PoleG97/mixed_signal_course/doc/front.png

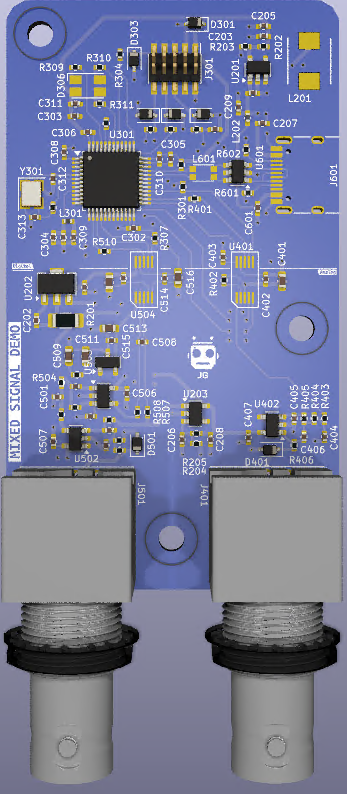
doc/front.png
