PoleG97/mixed_signal_course/outputs/blender_render/untitled.png

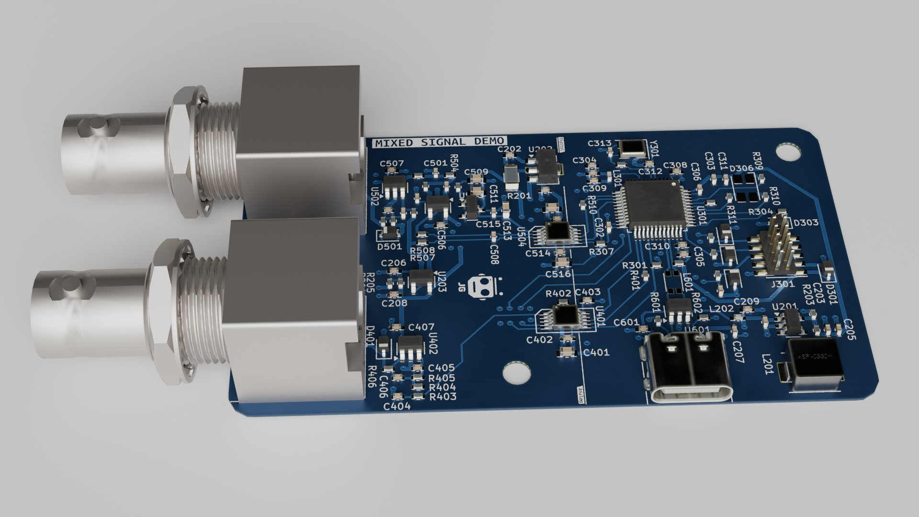
outputs/blender_render/untitled.png
