PoleG97/mixed_signal_course/doc/back.png

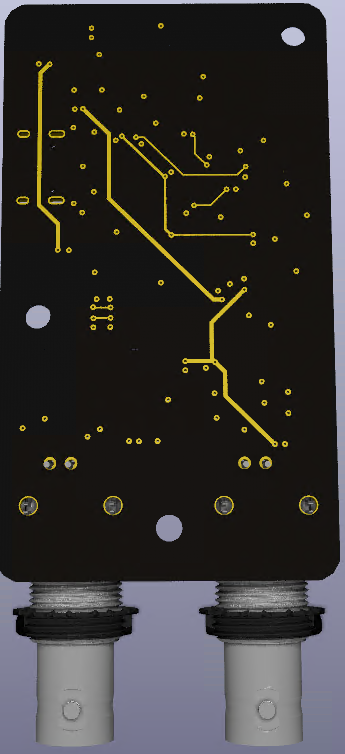
doc/back.png
