PoleG97/mixed_signal_course/outputs/mixed_signal.pdf

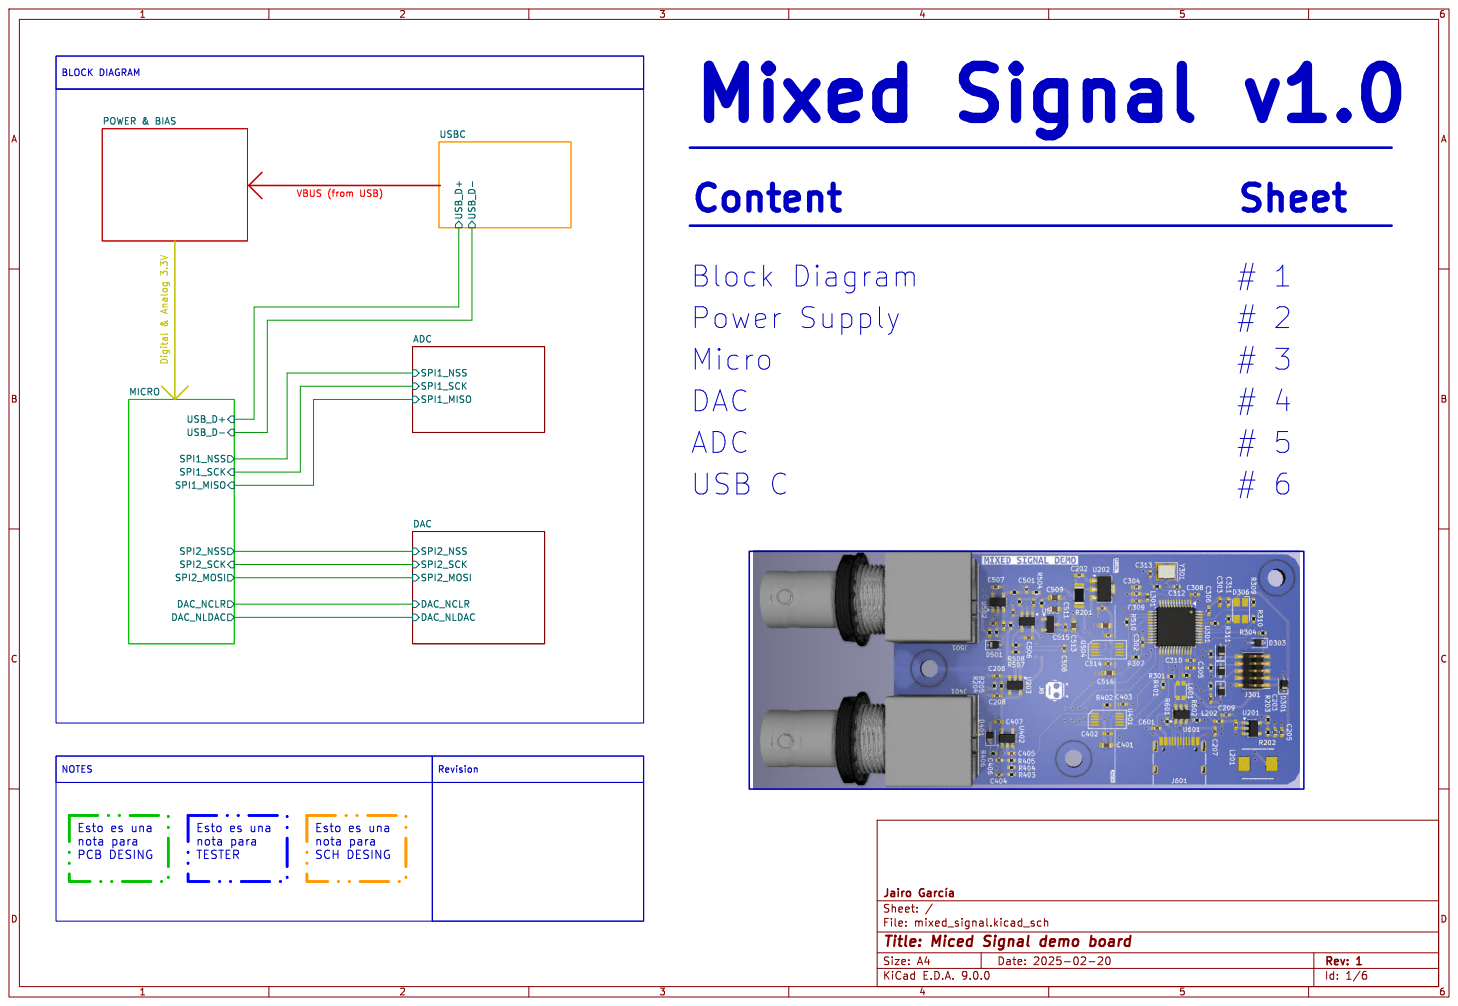
[picture p4: page 1]

Id: 1/6 Title: Miced Signal demo board

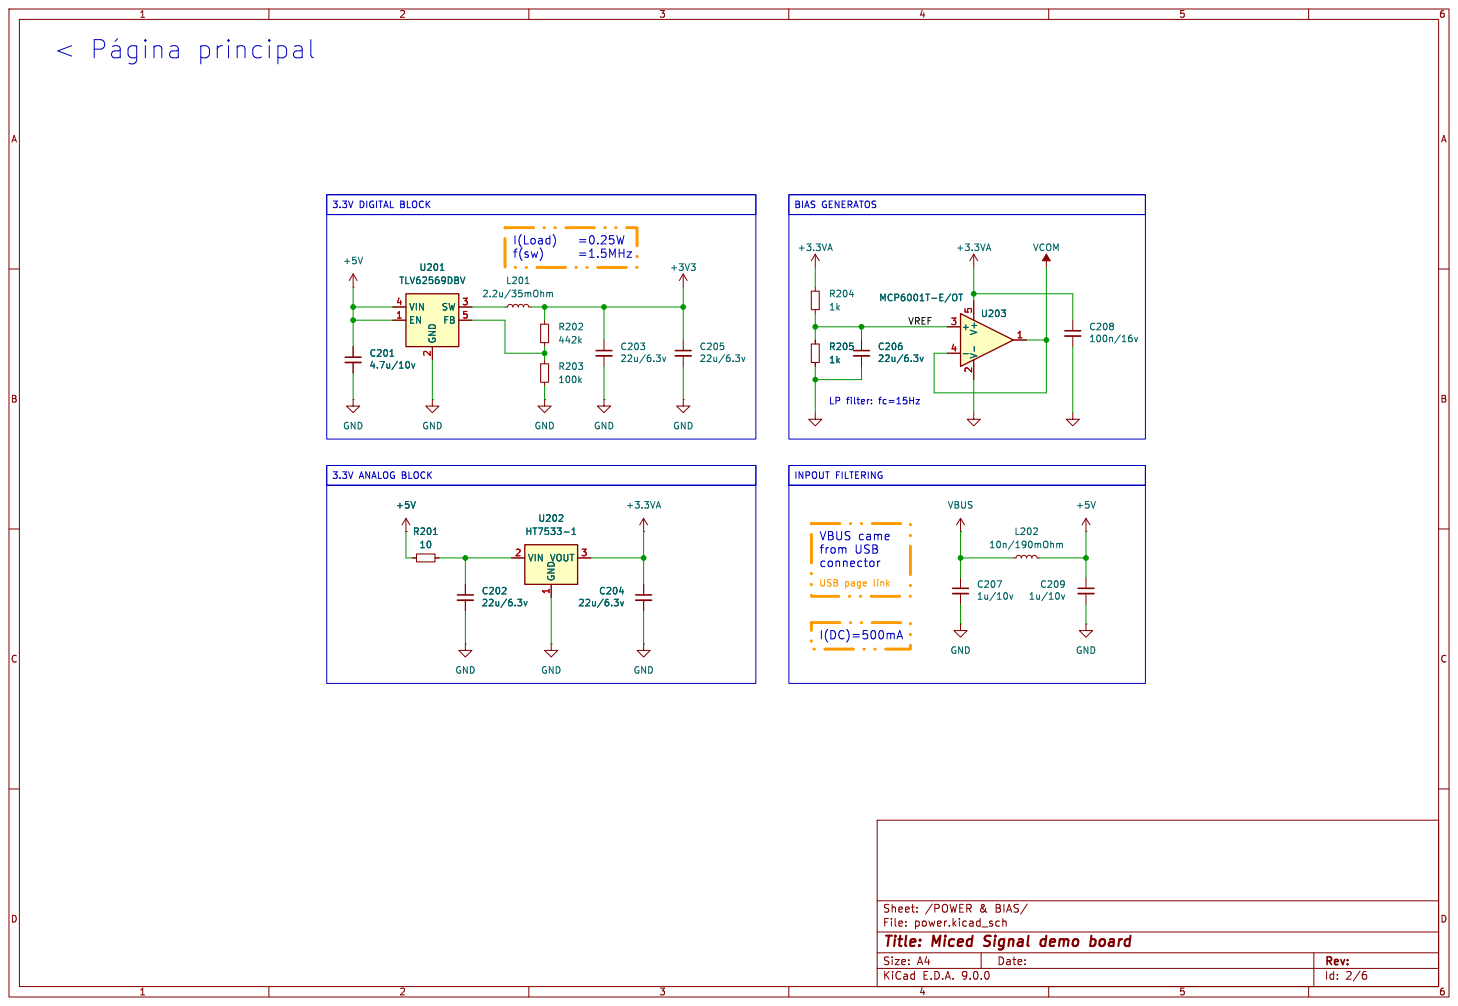
[picture p5: page 2]

Id: 2/6 Title: Miced Signal demo board

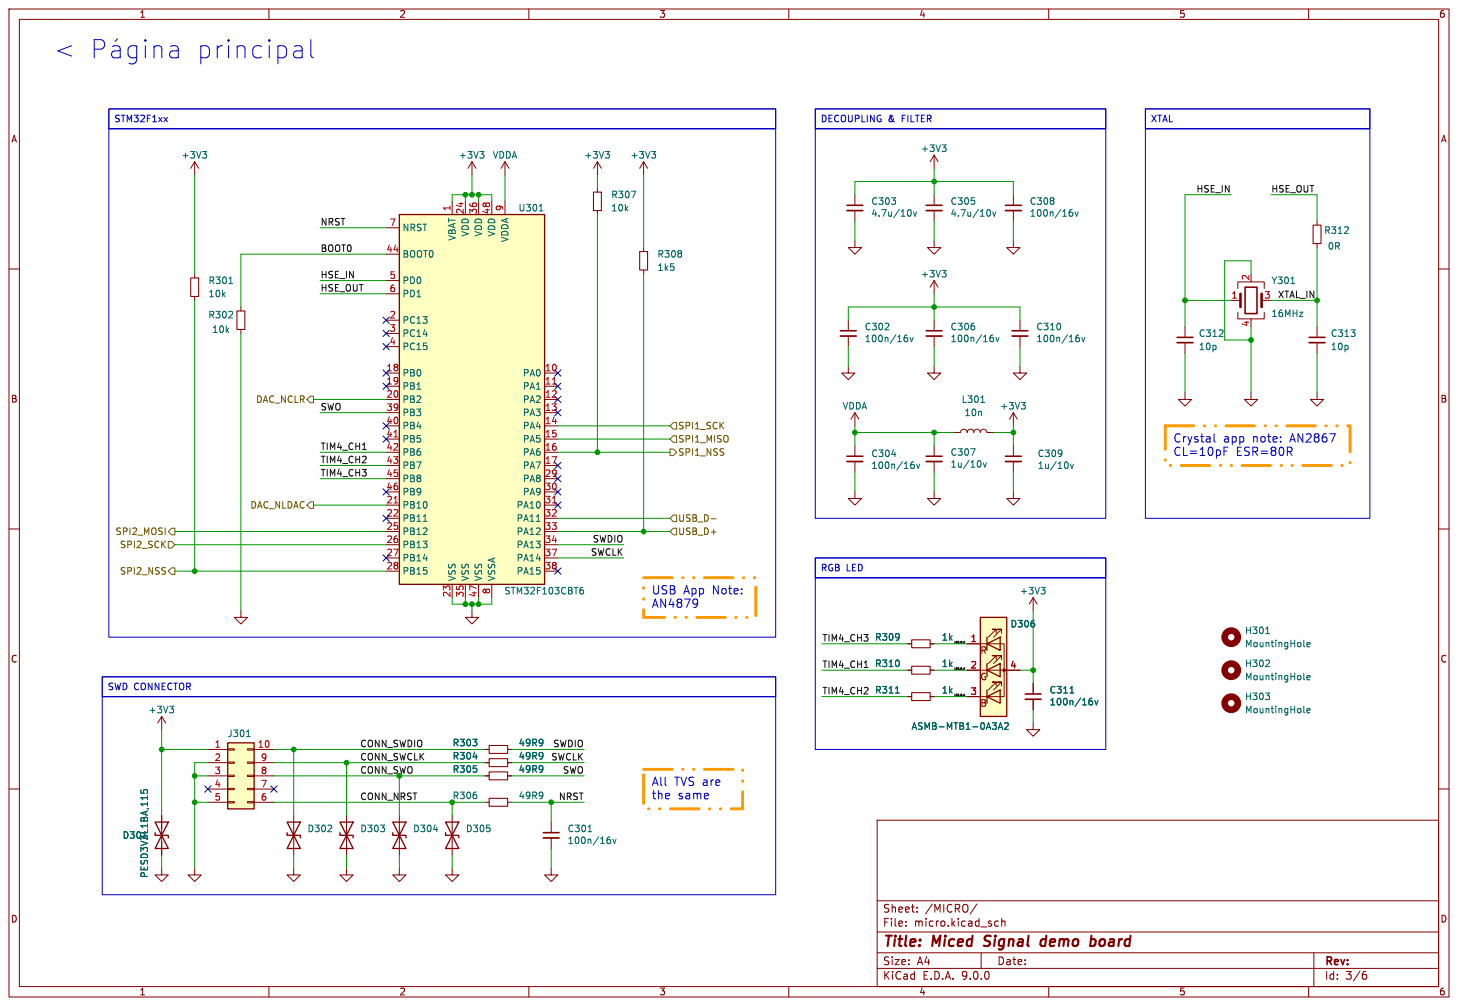
[picture p6: page 3]

1 VSS 23 VDD 24 VSS 35 VDD 36 VSS 47 VDD 48 VSSA

Id: 3/6 Title: Miced Signal demo board

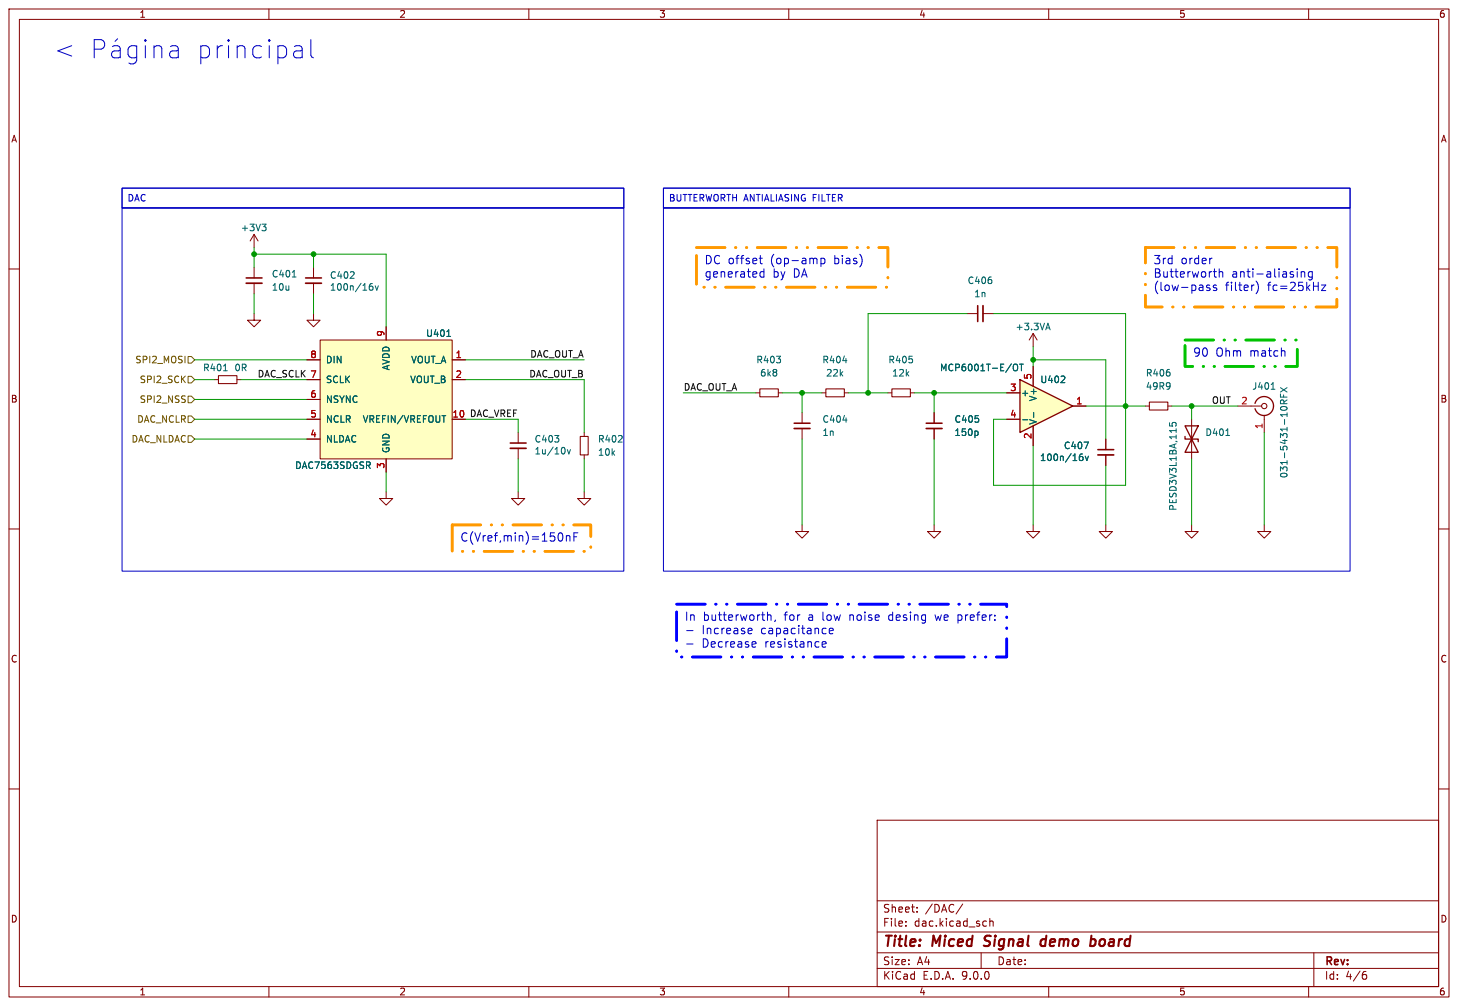
[picture p7: page 4]

3 DIN 8 SCLK 7 NSYNC 6 NCLR 5 NLDAC 4 U401 DAC7563SDGSR

3 DIN 8 SCLK 7 NSYNC 6 NCLR 5 NLDAC 4 C407

File: dac.kicad_sch Sheet: /DAC/
Id: 4/6 Title: Miced Signal demo board

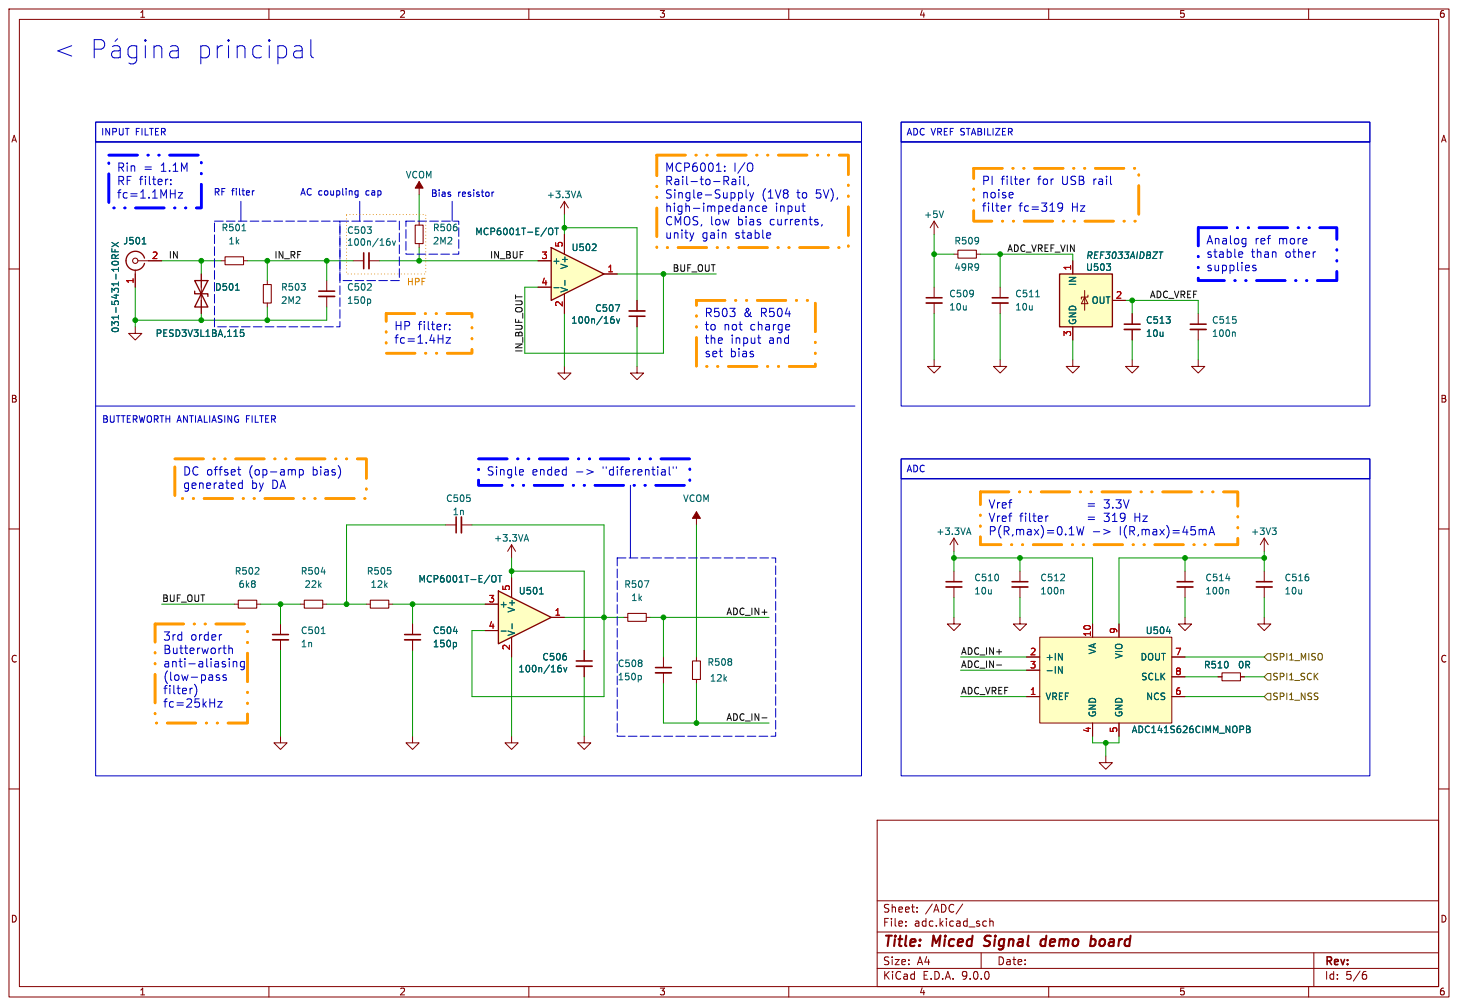
[picture p8: page 5]

MCP6001: I/O
Rail-to-Rail,
CMOS, low bias currents,
unity gain stable

PI filter for USB rail
noise

Id: 5/6 Title: Miced Signal demo board

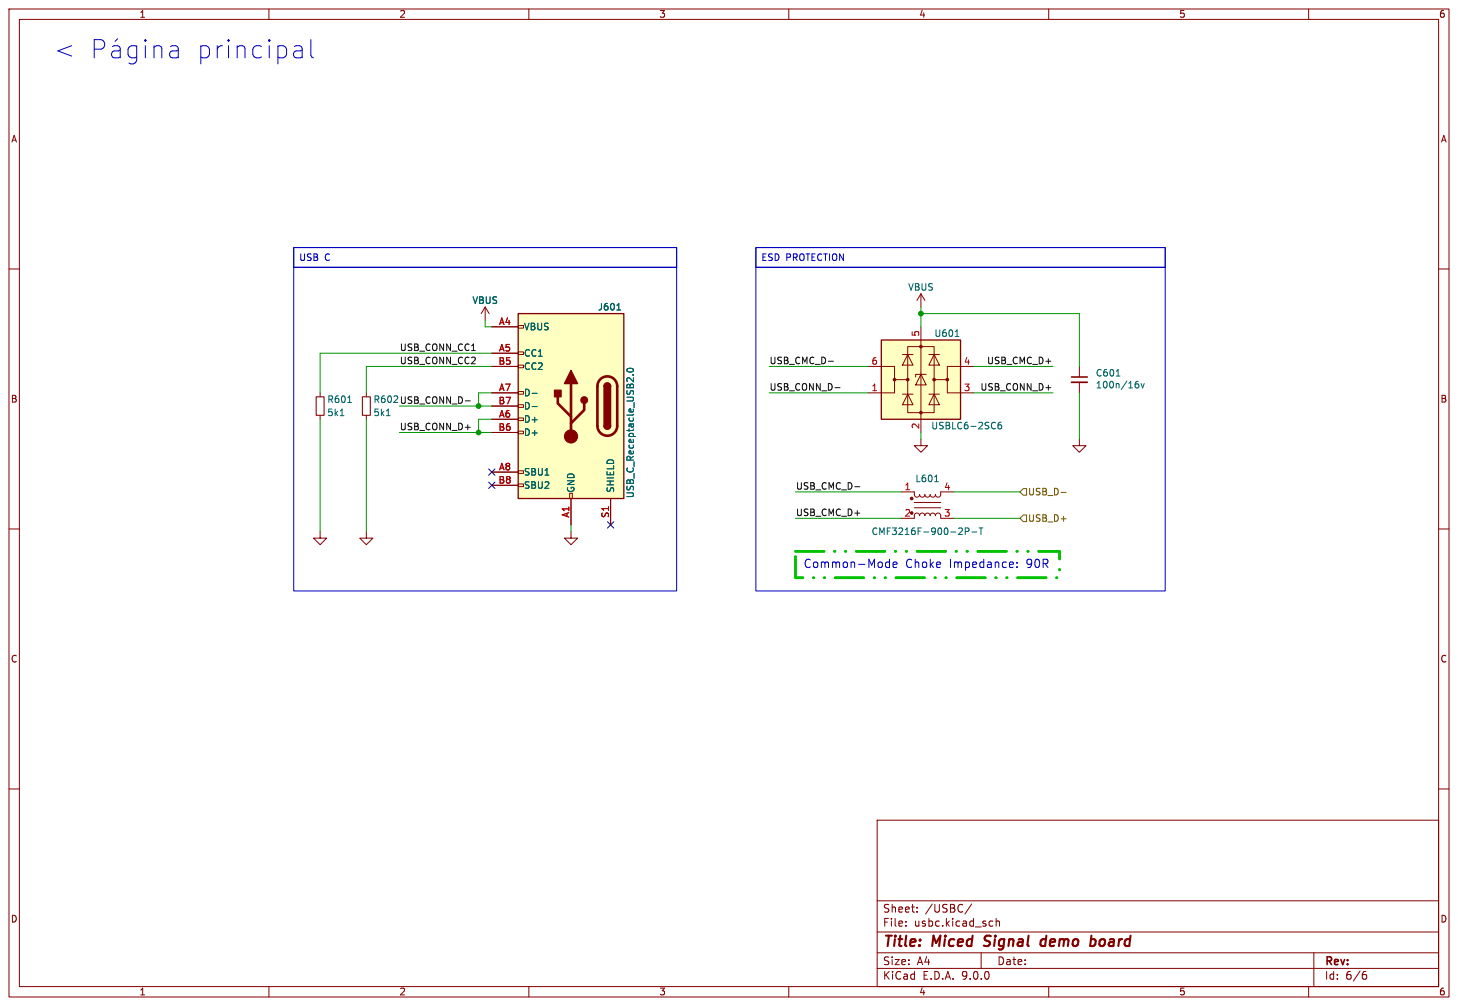
[picture p9: page 6]

File: usbc.kicad_sch Sheet: /USBC/
Id: 6/6 Title: Miced Signal demo board
