PoleG97/mixed_signal_course/outputs/file_outputs/SCH.pdf

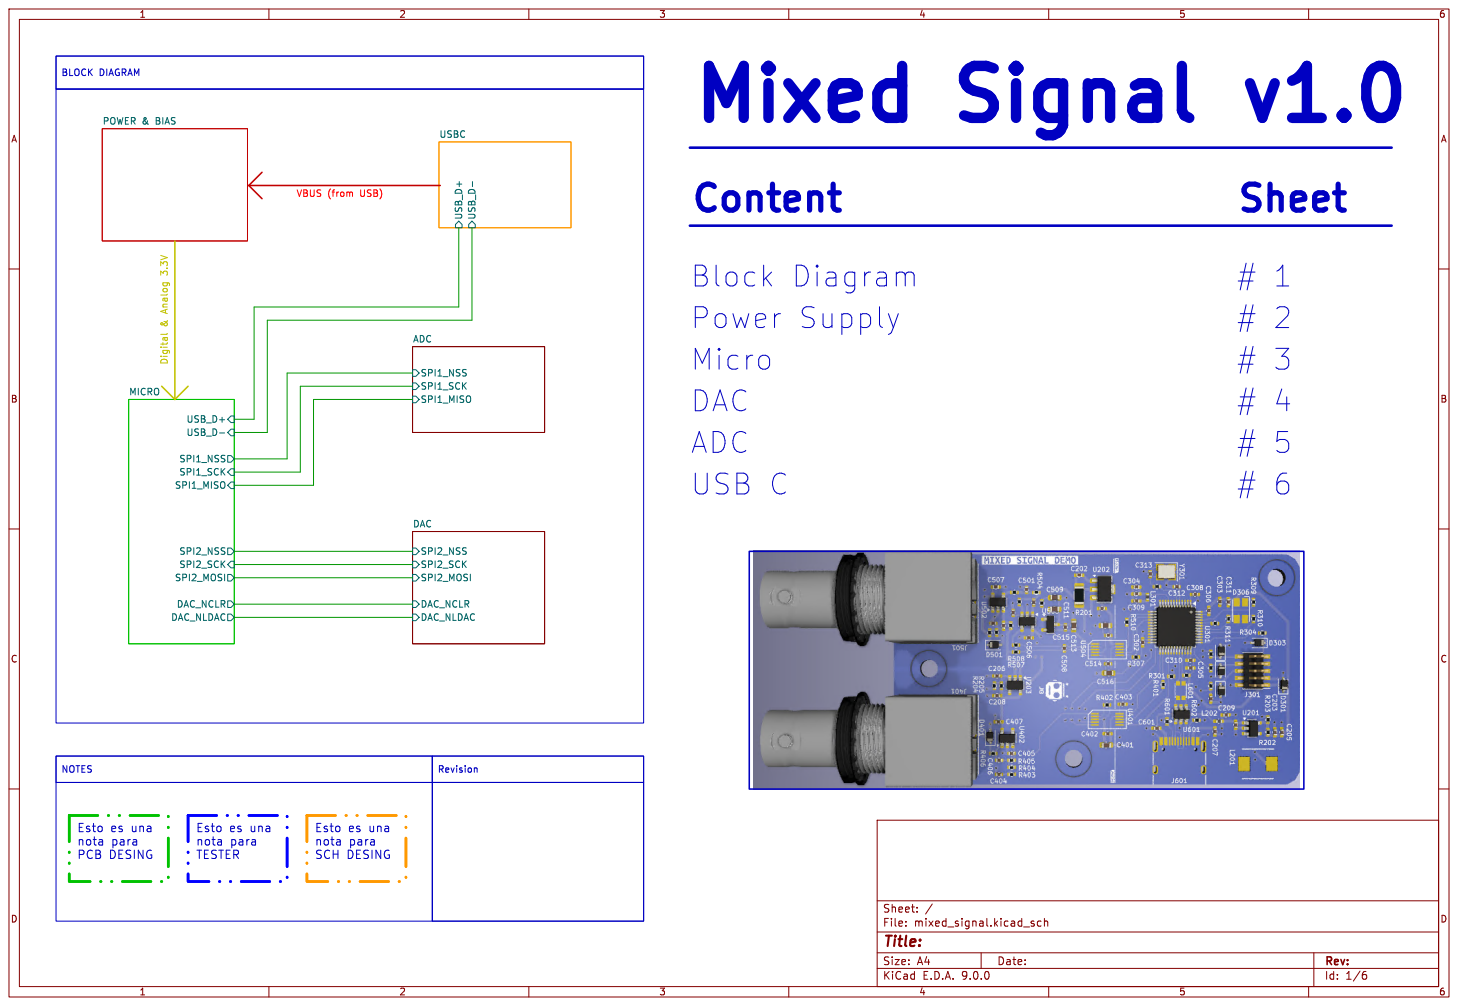
[picture p10: page 1]

BLOCK DIAGRAM Esto es una

Id: 1/6 Title: File: mixed_signal.kicad_sch Sheet: / DAC_NCLR
DAC_NLDAC

NOTES Esto es una

Revision

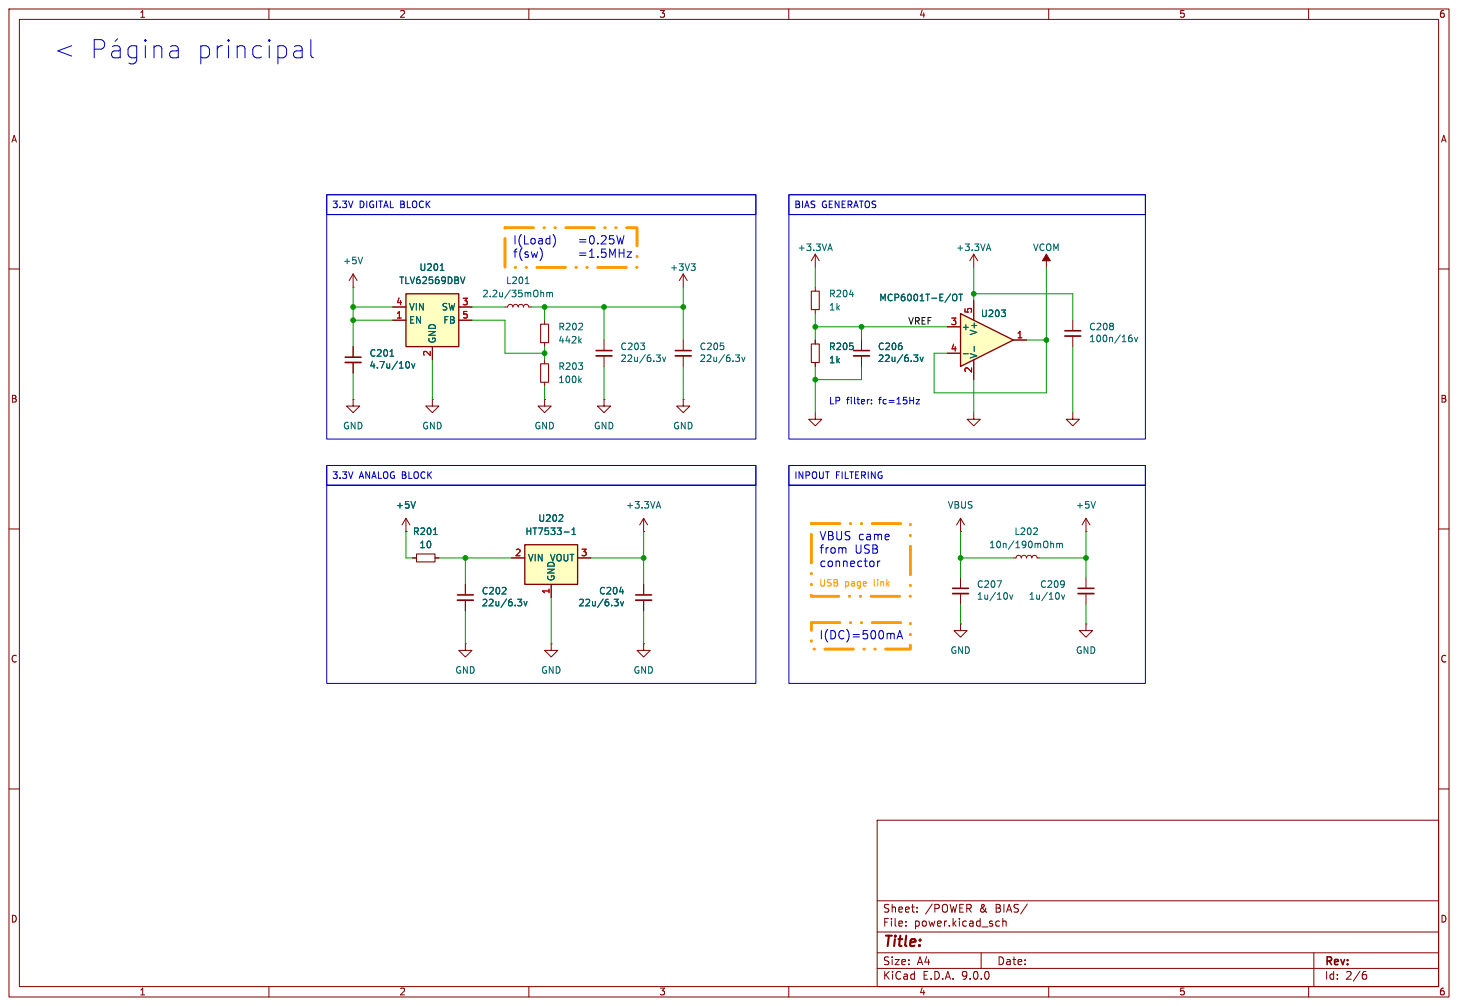
[picture p11: page 2]

INPOUT FILTERING < þÿPágina principal

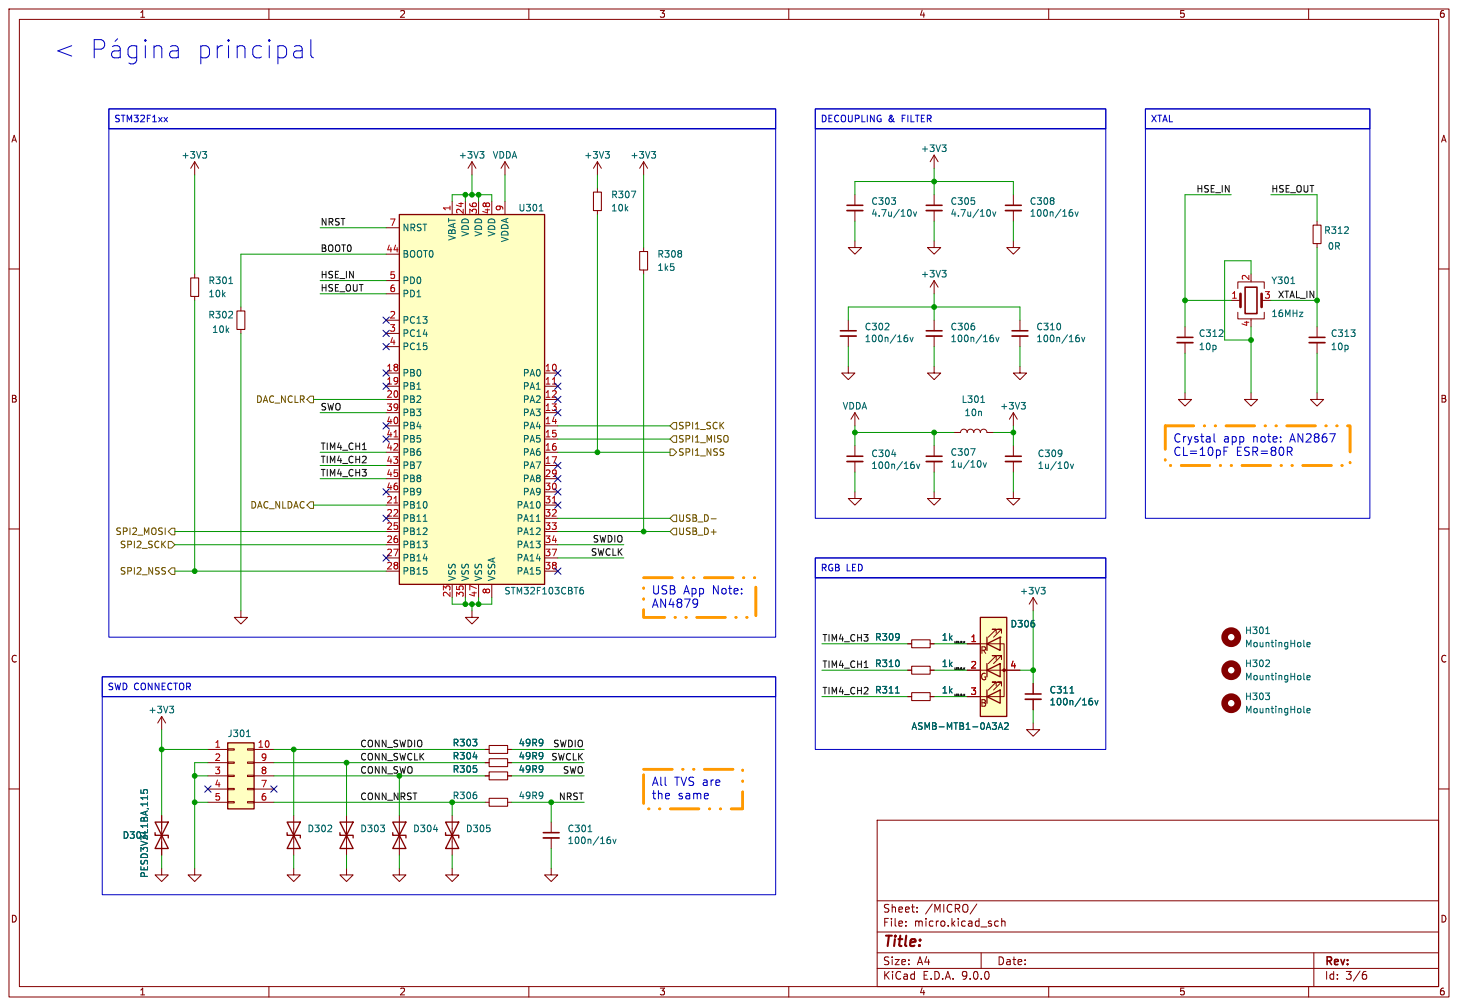
[picture p12: page 3]

1 VSS 23 VDD 24 VSS 35 VDD 36 VSS 47 VDD 48 VSSA

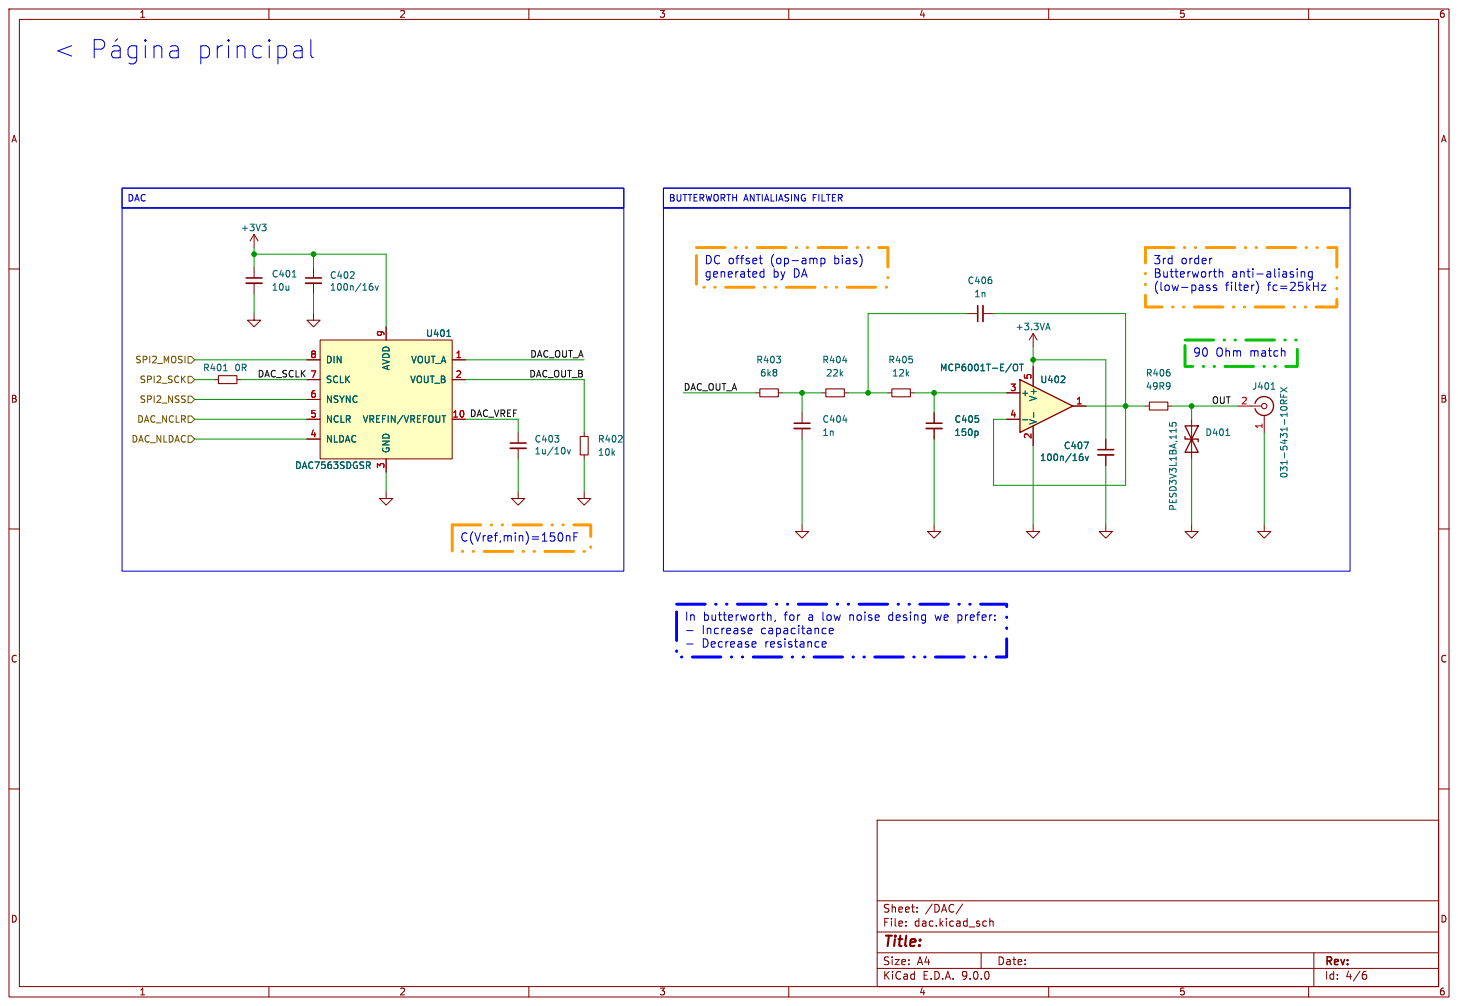
[picture p13: page 4]

3 DIN 8 SCLK 7 NSYNC 6 NCLR 5 NLDAC 4 U401 DAC7563SDGSR

3 DIN 8 SCLK 7 NSYNC 6 NCLR 5 NLDAC 4 C407

Id: 4/6 Title: File: dac.kicad_sch Sheet: /DAC/

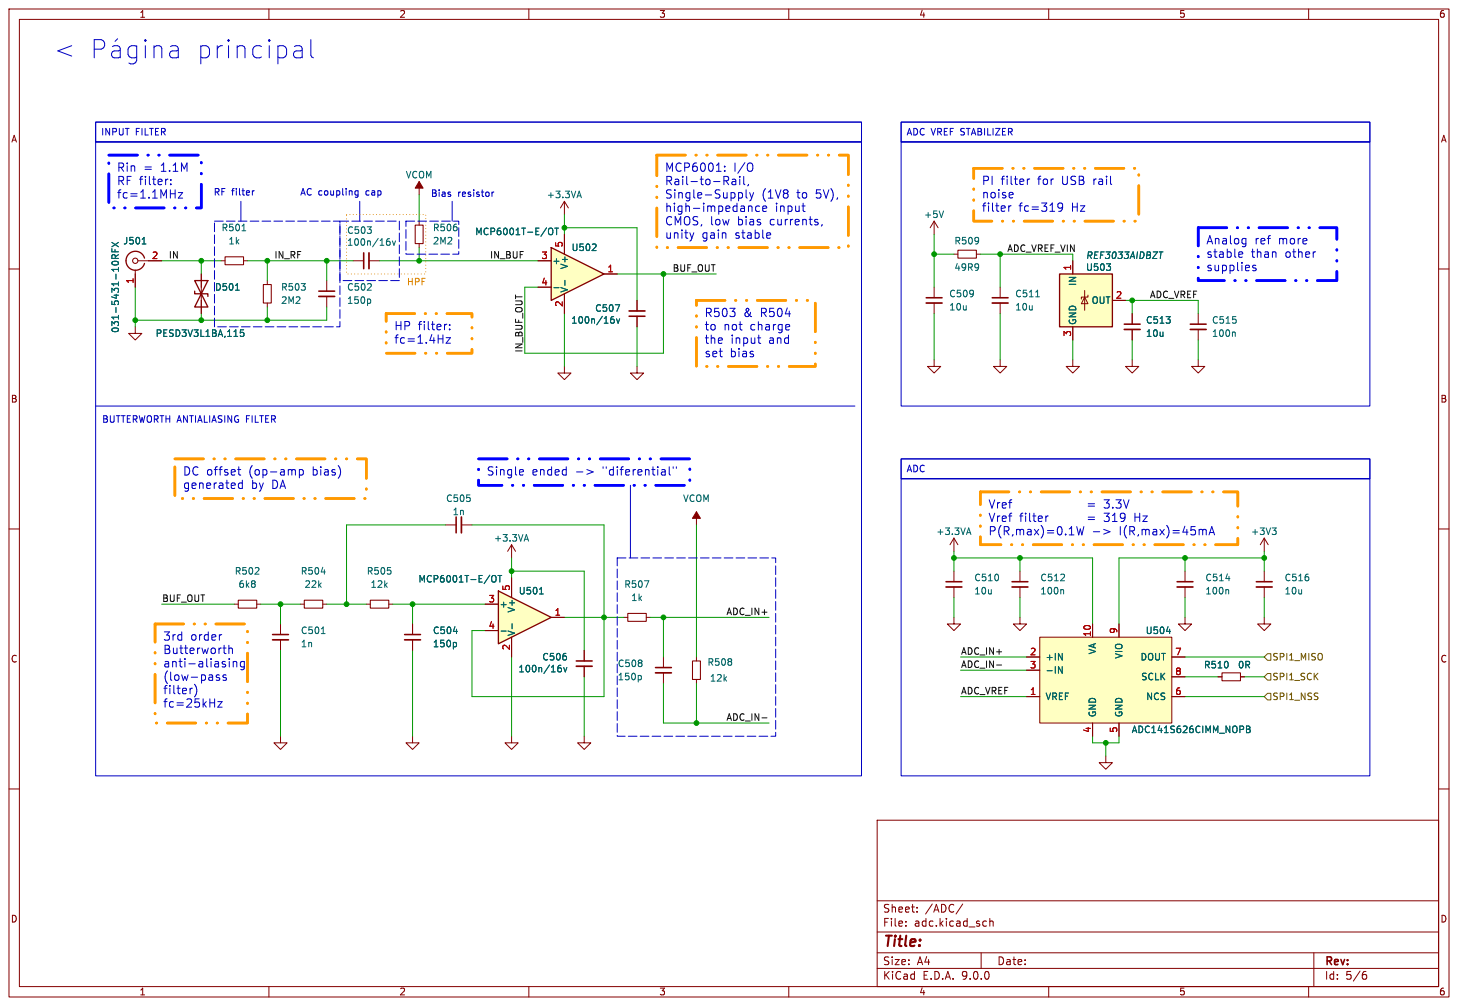
[picture p14: page 5]

MCP6001: I/O
Rail-to-Rail,
CMOS, low bias currents,
unity gain stable

Id: 5/6 Title: File: adc.kicad_sch Sheet: /ADC/

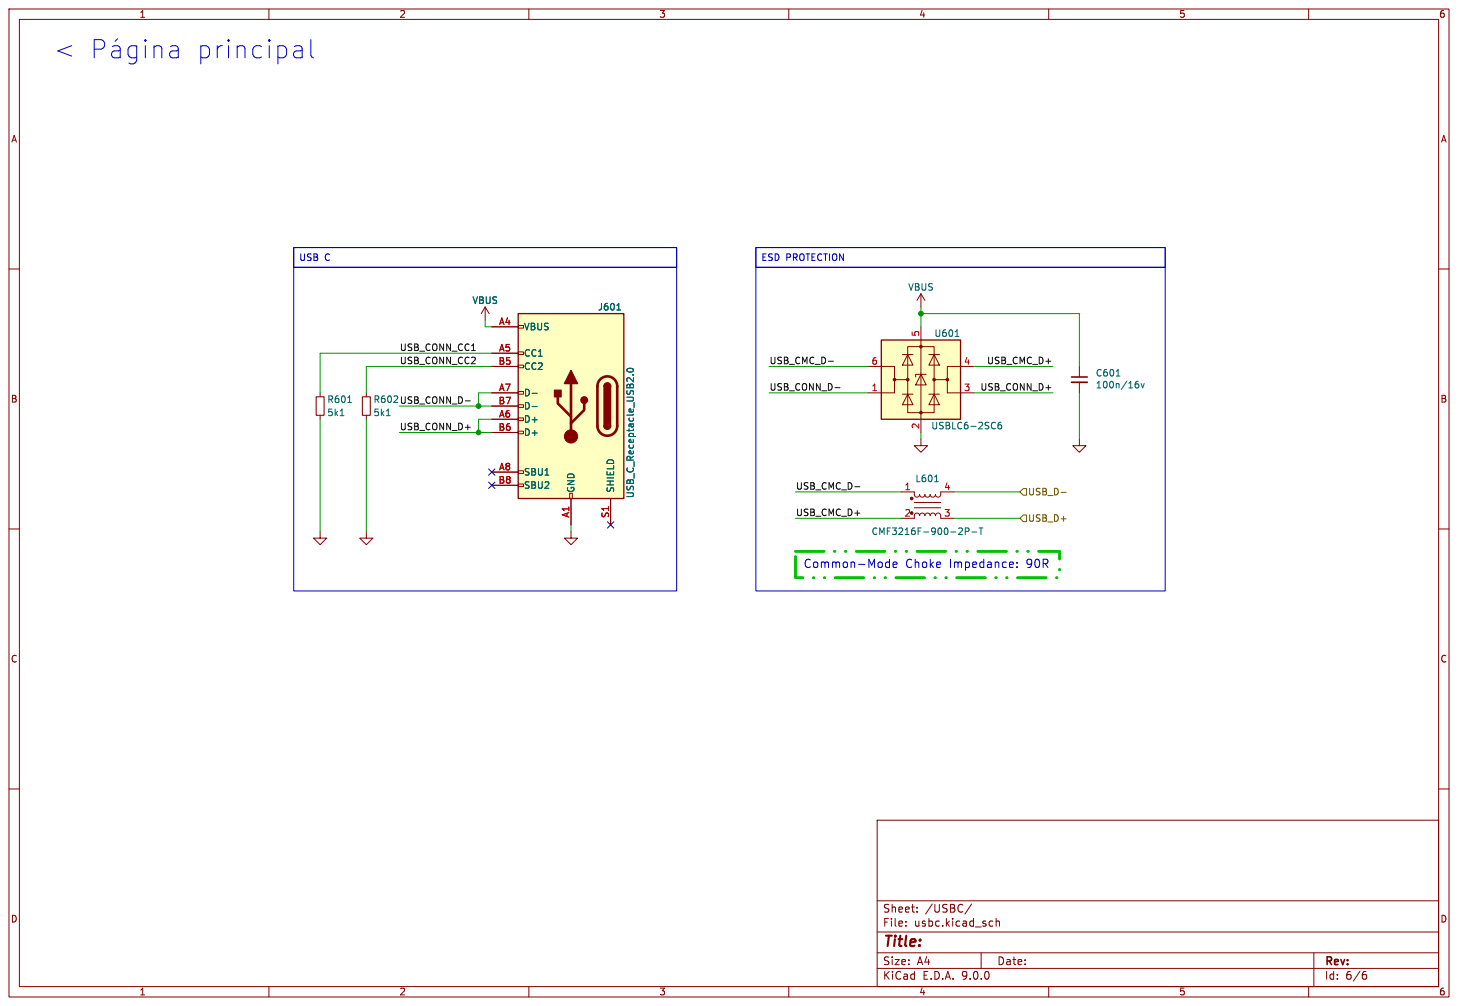
[picture p15: page 6]

Id: 6/6 Title: File: usbc.kicad_sch Sheet: /USBC/
