PoleG97/mixed_signal_course/mixed_signal.kicad_pcb

## KiCad design mixed_signal.kicad_pcb (2025-03-20)

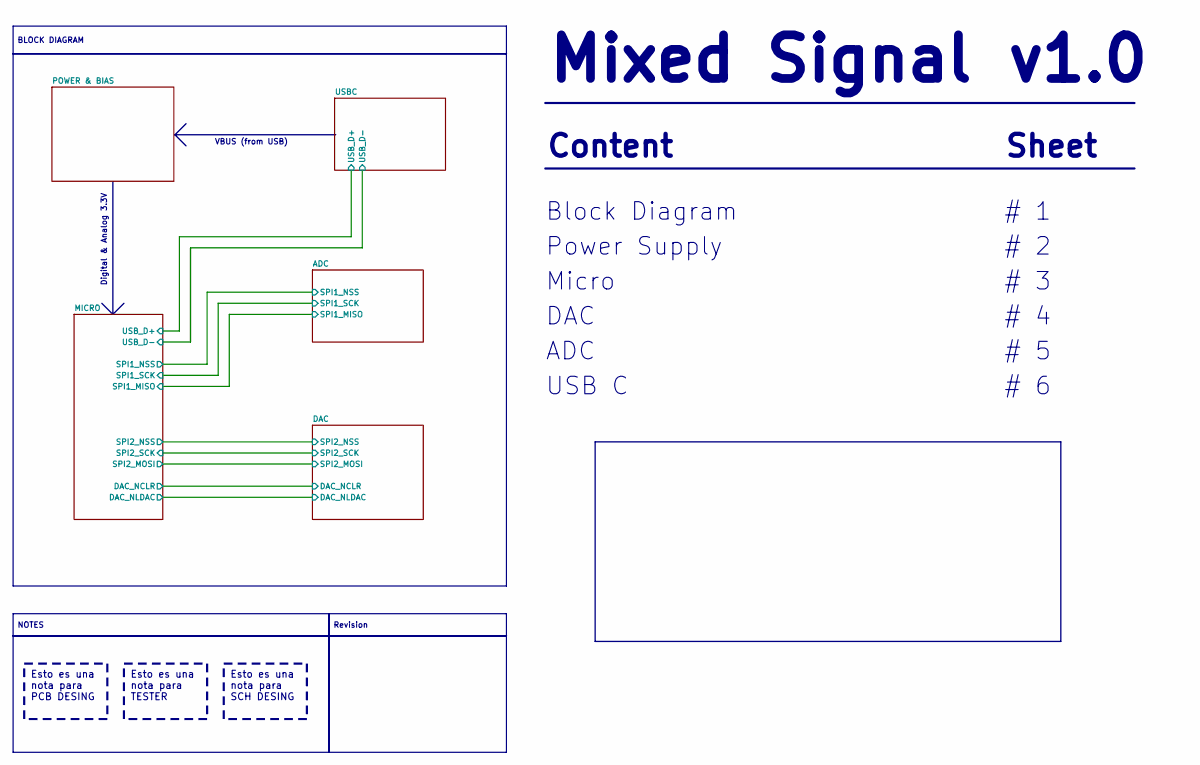
[picture p16: schematic mixed_signal.kicad_sch, Miced Signal demo board]

Notes on the sheet:
Micro
# 2
ADC
# 4
Power Supply
# 3
# 1
Content
USB C
v1.0
# 5
VBUS (from USB)
Block Diagram
Mixed Signal
DAC
Digital & Analog 3.3V
# 6
Sheet
Esto es una nota para TESTER
NOTES
Esto es una nota para SCH DESING
BLOCK DIAGRAM
Esto es una nota para PCB DESING
Revision

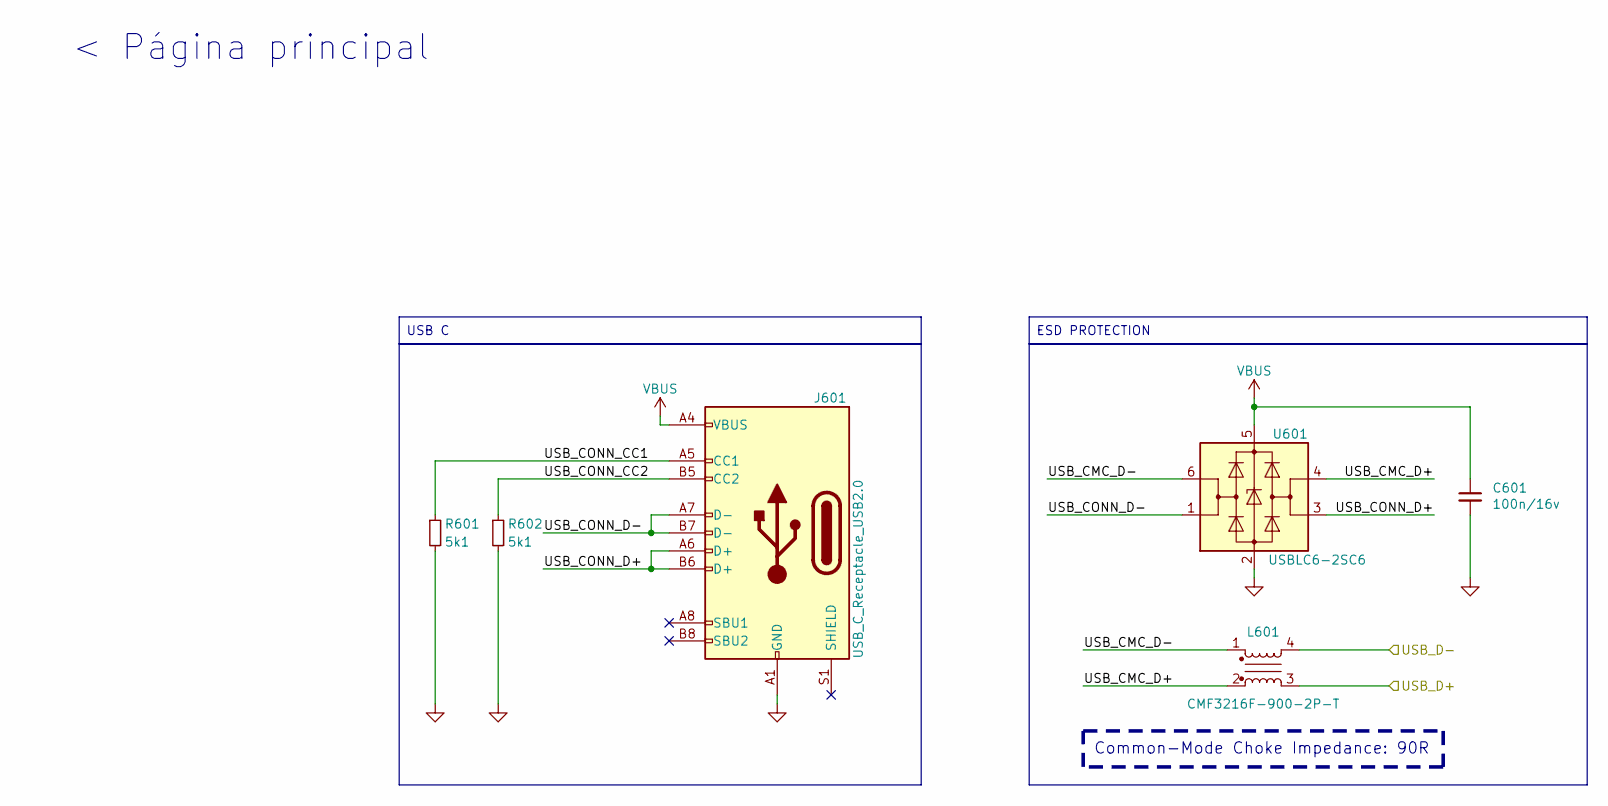
[picture p17: schematic usbc.kicad_sch, Miced Signal demo board]

Parts:
C601: 100n/16v; C_0402_1005Metric_Pad0.74x0.62mm_HandSolder; PART_NUMBER GRM155R71C104KA88J
J601: USB_C_Receptacle_USB2.0; USB_C_Receptacle_HRO_TYPE-C-31-M-12
L601: CMF3216F-900-2P-T; CMF3216F
R601, R602: 5k1; R_0402_1005Metric
U601: USBLC6-2SC6; SOT-23-6

Connections:
/MICRO/USB_D+: L601.3; also elsewhere on the board
/MICRO/USB_D-: L601.4; also elsewhere on the board
/USBC/USB_CMC_D+: L601.2, U601.4 (I/O2)
/USBC/USB_CMC_D-: L601.1, U601.6 (I/O1)
/USBC/USB_CONN_CC1: J601.A5 (CC1), R601.1
/USBC/USB_CONN_CC2: J601.B5 (CC2), R602.1
/USBC/USB_CONN_D+: J601.A6 (D+), J601.B6 (D+), U601.3 (I/O2)
/USBC/USB_CONN_D-: J601.A7 (D-), J601.B7 (D-), U601.1 (I/O1)
GND: C601.2, J601.A1 (GND), J601.A12 (GND), J601.B1 (GND), J601.B12 (GND), R601.2, R602.2, U601.2 (GND); also elsewhere on the board
VBUS: C601.1, J601.A4 (VBUS), J601.A9 (VBUS), J601.B4 (VBUS), J601.B9 (VBUS), U601.5 (VBUS); also elsewhere on the board

Notes on the sheet:
Common-Mode Choke Impedance: 90R
< Página principal
ESD PROTECTION
USB C

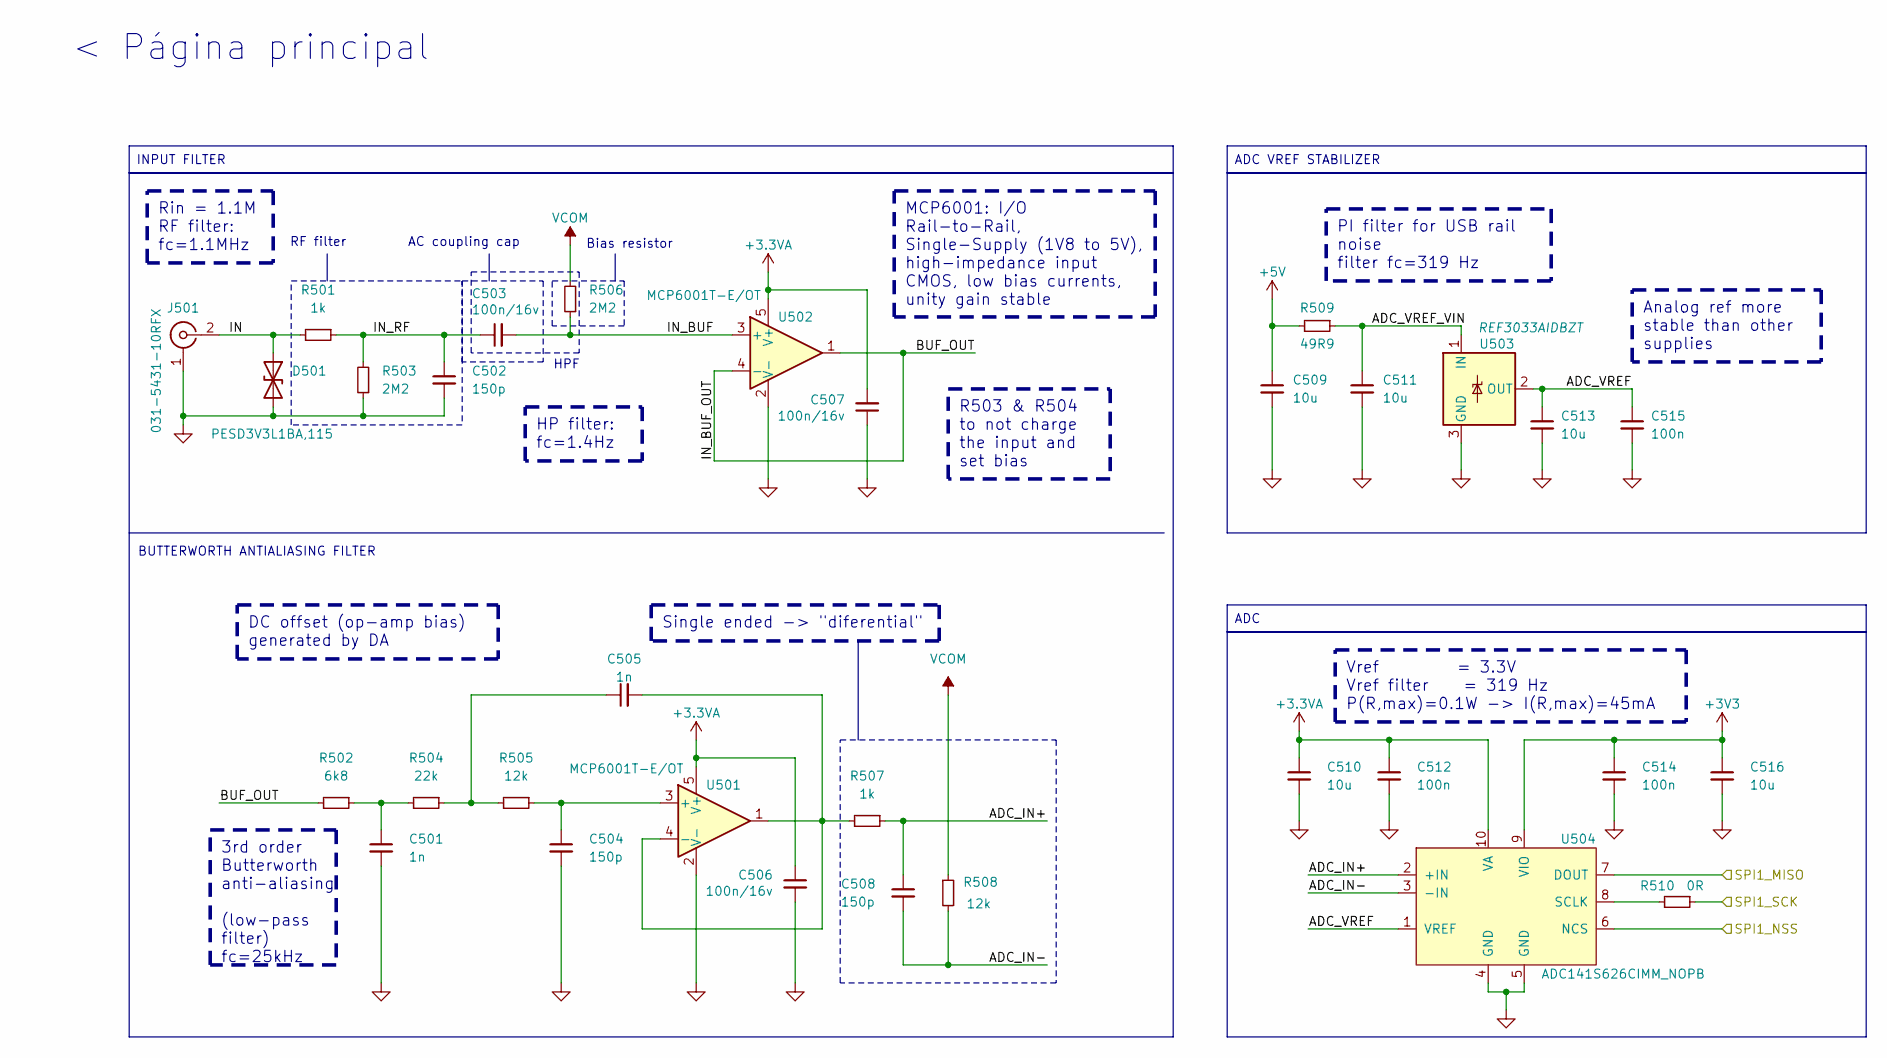
[picture p18: schematic adc.kicad_sch, Miced Signal demo board]

Parts:
C501, C505: 1n; C_0402_1005Metric
C502, C504, C508: 150p; C_0402_1005Metric
C503, C506, C507: 100n/16v; C_0402_1005Metric_Pad0.74x0.62mm_HandSolder; PART_NUMBER GRM155R71C104KA88J
C509, C510, C511, C513, C516: 10u; C_0603_1608Metric
C512, C514, C515: 100n; C_0402_1005Metric
D501: PESD3V3L1BA,115; D_SOD-323
J501: 031-5431-10RFX
R501, R507: 1k; R_0402_1005Metric
R502: 6k8; R_0402_1005Metric
R503, R506: 2M2; R_0402_1005Metric
R504: 22k; R_0402_1005Metric
R505, R508: 12k; R_0402_1005Metric
R509: 49R9; R_0402_1005Metric
R510: 0R; R_0402_1005Metric
U501, U502: MCP6001T-E/OT; SOT-23-5
U503: REF3033AIDBZT; SOT-23
U504: ADC141S626CIMM_NOPB; VSSOP-10

Connections:
+3.3VA: C506.1, C507.2, C510.1, C512.1, U501.5 (V+), U502.5 (V+), U504.10 (VA); also elsewhere on the board
+3V3: C514.1, C516.1, U504.9 (VIO); also elsewhere on the board
+5V: C509.1, R509.2; also elsewhere on the board
/ADC/ADC_IN+: C508.1, R507.1, U504.2 (+IN)
/ADC/ADC_IN-: C508.2, R508.2, U504.3 (-IN)
/ADC/ADC_VREF: C513.1, C515.1, U503.2 (OUT), U504.1 (VREF)
/ADC/ADC_VREF_VIN: C511.1, R509.1, U503.1 (IN)
/ADC/BUF_OUT: R502.2, U502.1, U502.4 (-)
/ADC/IN: D501.1 (A1), J501.2 (Ext), R501.2
/ADC/IN_BUF: C503.2, R506.1, U502.3 (+)
/ADC/IN_RF: C502.1, C503.1, R501.1, R503.2
/ADC/SPI1_MISO: U504.7 (DOUT); also elsewhere on the board
/ADC/SPI1_NSS: U504.6 (NCS); also elsewhere on the board
/ADC/SPI1_SCK: R510.1; also elsewhere on the board
GND: C501.2, C502.2, C504.2, C506.2, C507.1, C509.2, C510.2, C511.2, C512.2, C513.2, C514.2, C515.2, C516.2, D501.2 (A2), J501.1 (In), R503.1, U501.2 (V-), U502.2 (V-), U503.3 (GND), U504.4 (GND), U504.5 (GND); also elsewhere on the board
unnamed: C501.1, R502.1, R504.2
unnamed: C505.1, R504.1, R505.2
unnamed: C504.1, R505.1, U501.3 (+)
unnamed: C505.2, R507.2, U501.1, U501.4 (-)
unnamed: R510.2, U504.8 (SCLK)
VCOM: R506.2, R508.1; also elsewhere on the board

Notes on the sheet:
RF filter
AC coupling cap
HPF
BUTTERWORTH ANTIALIASING FILTER
Bias resistor
ADC
Vref = 3.3V Vref filter = 319 Hz P(R,max)=0.1W -> I(R,max)=45mA
HP filter: fc=1.4Hz
INPUT FILTER
ADC VREF STABILIZER
Single ended -> "diferential"
MCP6001: I/O Rail-to-Rail, Single-Supply (1V8 to 5V), high-impedance input CMOS, low bias currents, unity gain stable
PI filter for USB rail noise filter fc=319 Hz
Rin = 1.1M RF filter: fc=1.1MHz
DC offset (op-amp bias) generated by DA
3rd order Butterworth anti-aliasing (low-pass filter) fc=25kHz
Analog ref more stable than other supplies
R503 & R504 to not charge the input and set bias
< Página principal

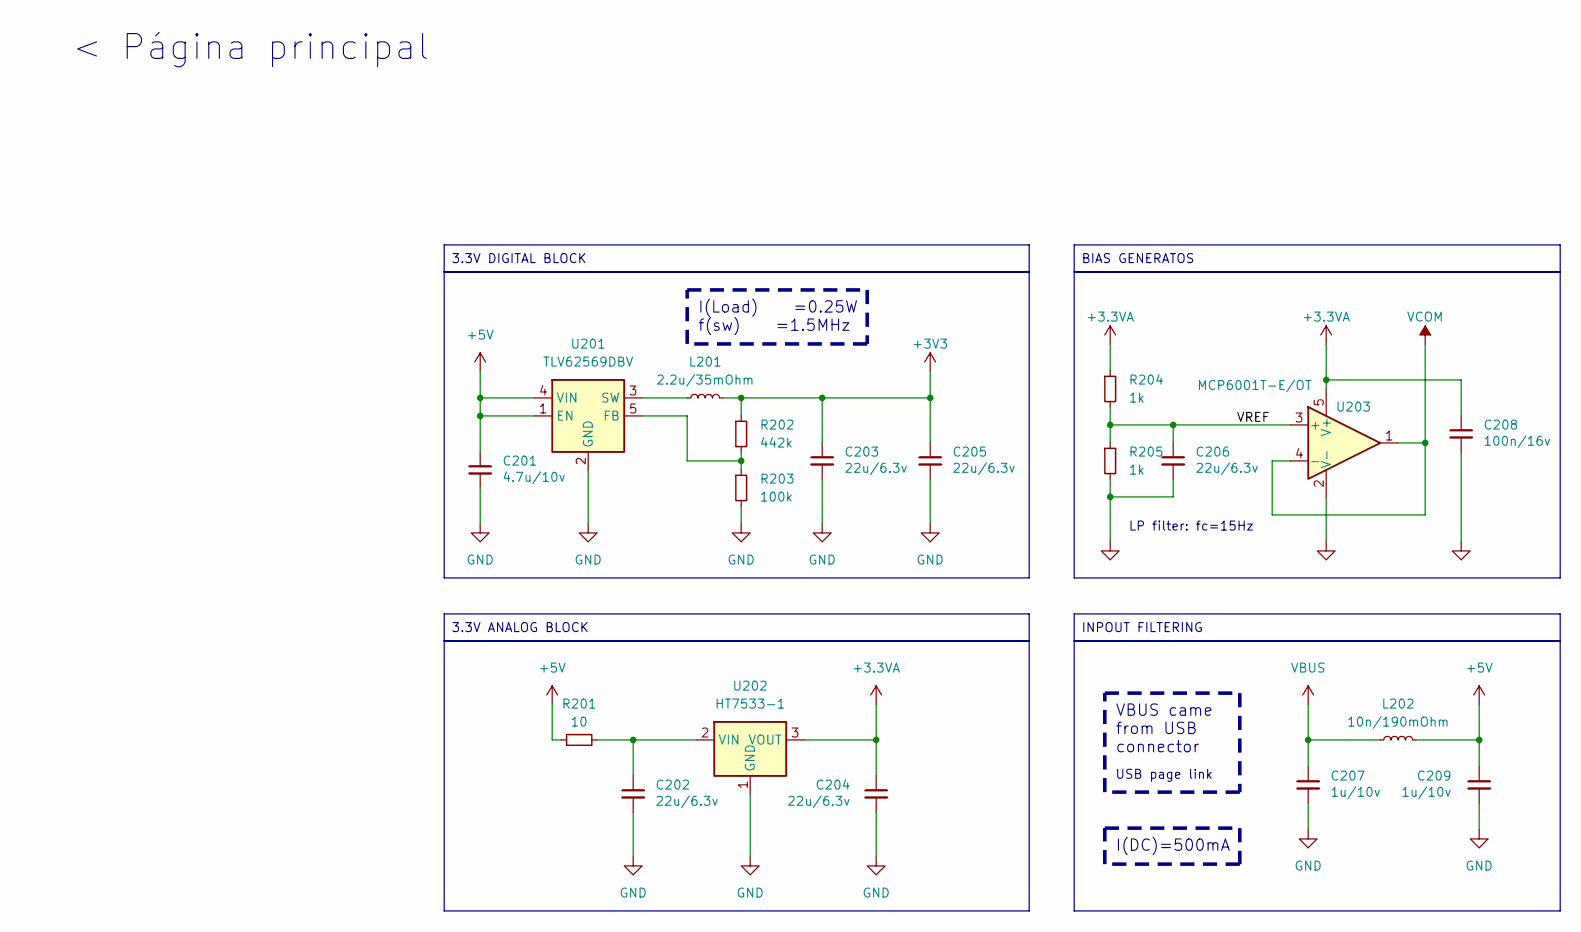
[picture p19: schematic power.kicad_sch, Miced Signal demo board]

Parts:
C201: 4.7u/10v; C_0402_1005Metric_Pad0.74x0.62mm_HandSolder; PART_NUMBER C1005X5R1A475K050BC
C202, C203, C204, C205, C206: 22u/6.3v; C_0402_1005Metric_Pad0.74x0.62mm_HandSolder; PART_NUMBER GRJ155R60J106ME11D
C207, C209: 1u/10v; C_0402_1005Metric_Pad0.74x0.62mm_HandSolder; PART_NUMBER CL05B104KP5NNNC
C208: 100n/16v; C_0402_1005Metric_Pad0.74x0.62mm_HandSolder; PART_NUMBER GRM155R71C104KA88J
L201: 2.2u/35mOhm; IND_ASPI-0530HI-2R2M-T2; PART_NUMBER ASPI-0530HI-2R2M-T2
L202: 10n/190mOhm; L_0402_1005Metric_Pad0.77x0.64mm_HandSolder; PART_NUMBER LQG15WZ10NH02D
R201: 10; R_1206_3216Metric_Pad1.30x1.75mm_HandSolder; PART_NUMBER Susumu
R202: 442k; R_0402_1005Metric
R203: 100k; R_0402_1005Metric
R204, R205: 1k; R_0402_1005Metric; PART_NUMBER ERJ-2RKF1001X
U201: TLV62569DBV; SOT-23-5
U202: HT7533-1; SOT-89-3
U203: MCP6001T-E/OT; SOT-23-5; PART_NUMBER MCP6001T-E/OT

Connections:
+3.3VA: C204.1, C208.1, R204.1, U202.3 (VOUT), U203.5 (V+); also elsewhere on the board
+3V3: C203.1, C205.1, L201.2, R202.1; also elsewhere on the board
+5V: C201.1, C209.1, L202.2, R201.1, U201.1 (EN), U201.4 (VIN); also elsewhere on the board
/POWER & BIAS/VREF: C206.1, R204.2, R205.1, U203.3 (+)
GND: C201.2, C202.2, C203.2, C204.2, C205.2, C206.2, C207.2, C208.2, C209.2, R203.2, R205.2, U201.2 (GND), U202.1 (GND), U203.2 (V-); also elsewhere on the board
unnamed: R202.2, R203.1, U201.5 (FB)
unnamed: L201.1, U201.3 (SW)
unnamed: C202.1, R201.2, U202.2 (VIN)
VBUS: C207.1, L202.1; also elsewhere on the board
VCOM: U203.1, U203.4 (-); also elsewhere on the board

Notes on the sheet:
LP filter: fc=15Hz
USB page link
3.3V DIGITAL BLOCK
< Página principal
BIAS GENERATOS
3.3V ANALOG BLOCK
VBUS came from USB connector
I(DC)=500mA
INPOUT FILTERING
I(Load) =0.25W f(sw) =1.5MHz

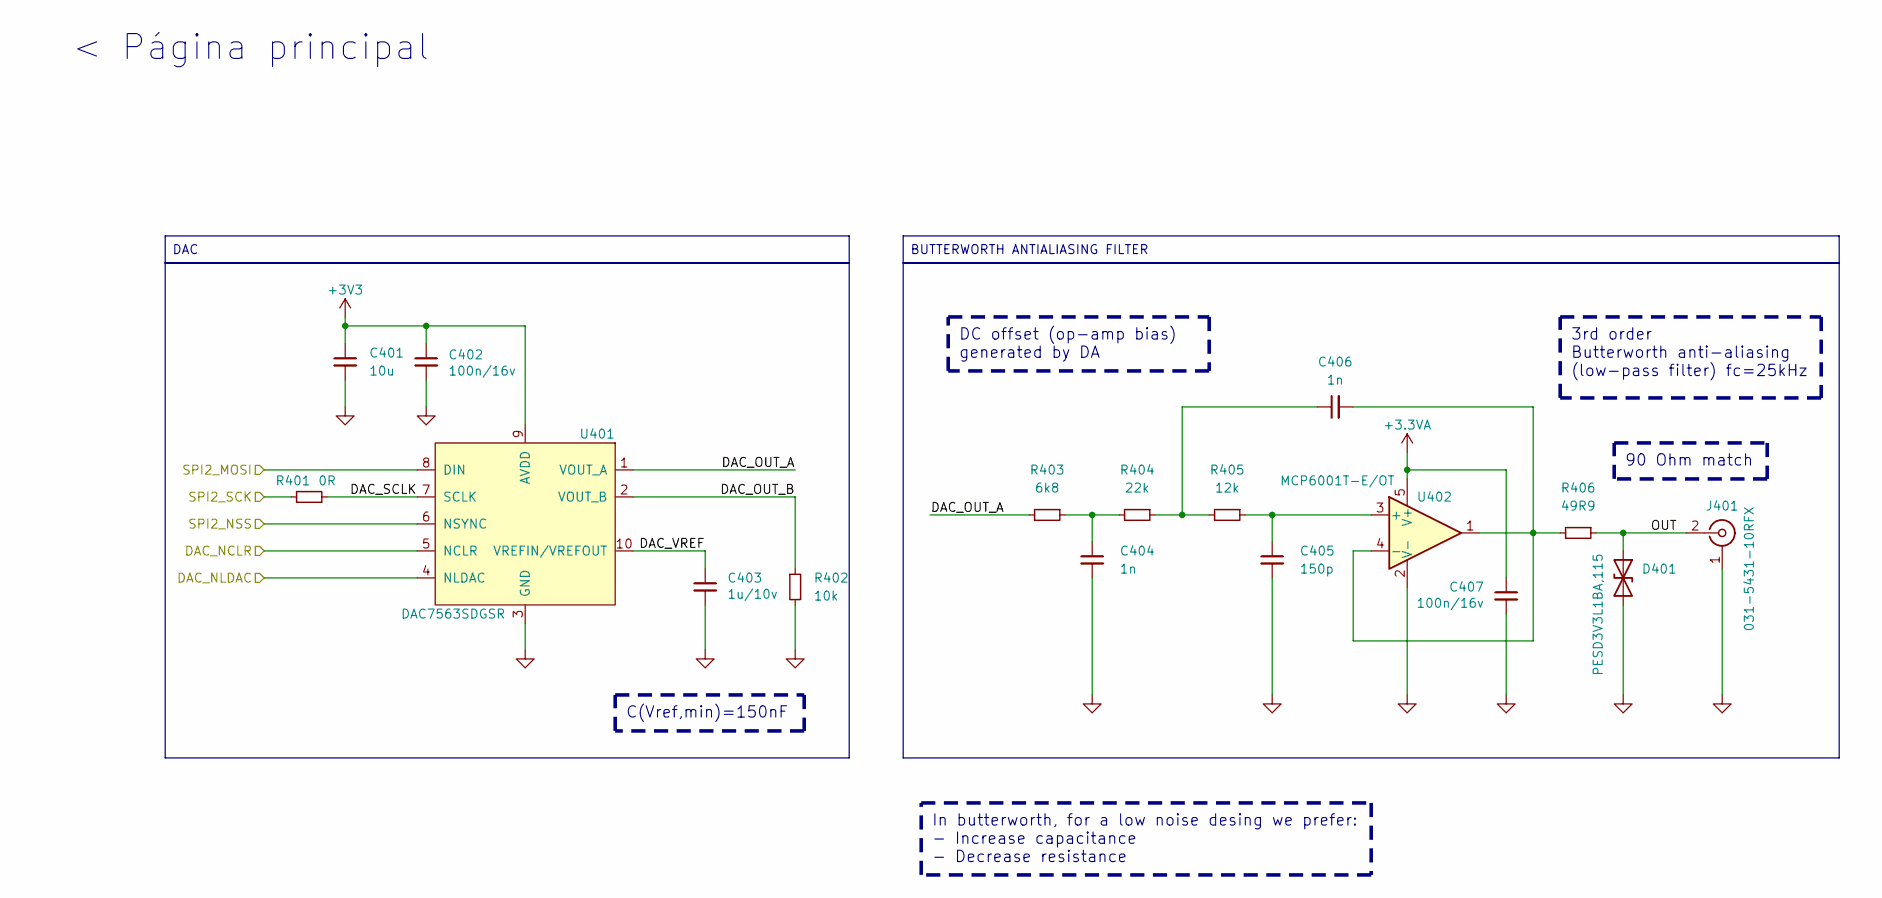
[picture p20: schematic dac.kicad_sch, Miced Signal demo board]

Parts:
C401: 10u; C_0603_1608Metric
C402, C407: 100n/16v; C_0402_1005Metric_Pad0.74x0.62mm_HandSolder; PART_NUMBER GRM155R71C104KA88J
C403: 1u/10v; C_0402_1005Metric_Pad0.74x0.62mm_HandSolder; PART_NUMBER CL05B104KP5NNNC
C404, C406: 1n; C_0402_1005Metric
C405: 150p; C_0402_1005Metric
D401: PESD3V3L1BA,115; D_SOD-323
J401: 031-5431-10RFX
R401: 0R; R_0402_1005Metric
R402: 10k; R_0402_1005Metric
R403: 6k8; R_0402_1005Metric
R404: 22k; R_0402_1005Metric
R405: 12k; R_0402_1005Metric
R406: 49R9; R_0402_1005Metric
U401: DAC7563SDGSR; VSSOP-10
U402: MCP6001T-E/OT; SOT-23-5

Connections:
+3.3VA: C407.1, U402.5 (V+); also elsewhere on the board
+3V3: C401.1, C402.1, U401.9 (AVDD); also elsewhere on the board
/DAC/DAC_NCLR: U401.5 (NCLR); also elsewhere on the board
/DAC/DAC_NLDAC: U401.4 (NLDAC); also elsewhere on the board
/DAC/DAC_OUT_A: R403.2, U401.1 (VOUT_A)
/DAC/DAC_OUT_B: R402.1, U401.2 (VOUT_B)
/DAC/DAC_SCLK: R401.2, U401.7 (SCLK)
/DAC/DAC_VREF: C403.1, U401.10 (VREFIN/VREFOUT)
/DAC/OUT: D401.1 (A1), J401.2 (Ext), R406.1
/DAC/SPI2_MOSI: U401.8 (DIN); also elsewhere on the board
/DAC/SPI2_NSS: U401.6 (NSYNC); also elsewhere on the board
/DAC/SPI2_SCK: R401.1; also elsewhere on the board
GND: C401.2, C402.2, C403.2, C404.2, C405.2, C407.2, D401.2 (A2), J401.1 (In), R402.2, U401.3 (GND), U402.2 (V-); also elsewhere on the board
unnamed: C404.1, R403.1, R404.2
unnamed: C406.1, R404.1, R405.2
unnamed: C405.1, R405.1, U402.3 (+)
unnamed: C406.2, R406.2, U402.1, U402.4 (-)

Notes on the sheet:
< Página principal
DAC
In butterworth, for a low noise desing we prefer: - Increase capacitance - Decrease resistance
C(Vref,min)=150nF
DC offset (op-amp bias) generated by DA
BUTTERWORTH ANTIALIASING FILTER
90 Ohm match
3rd order Butterworth anti-aliasing (low-pass filter) fc=25kHz

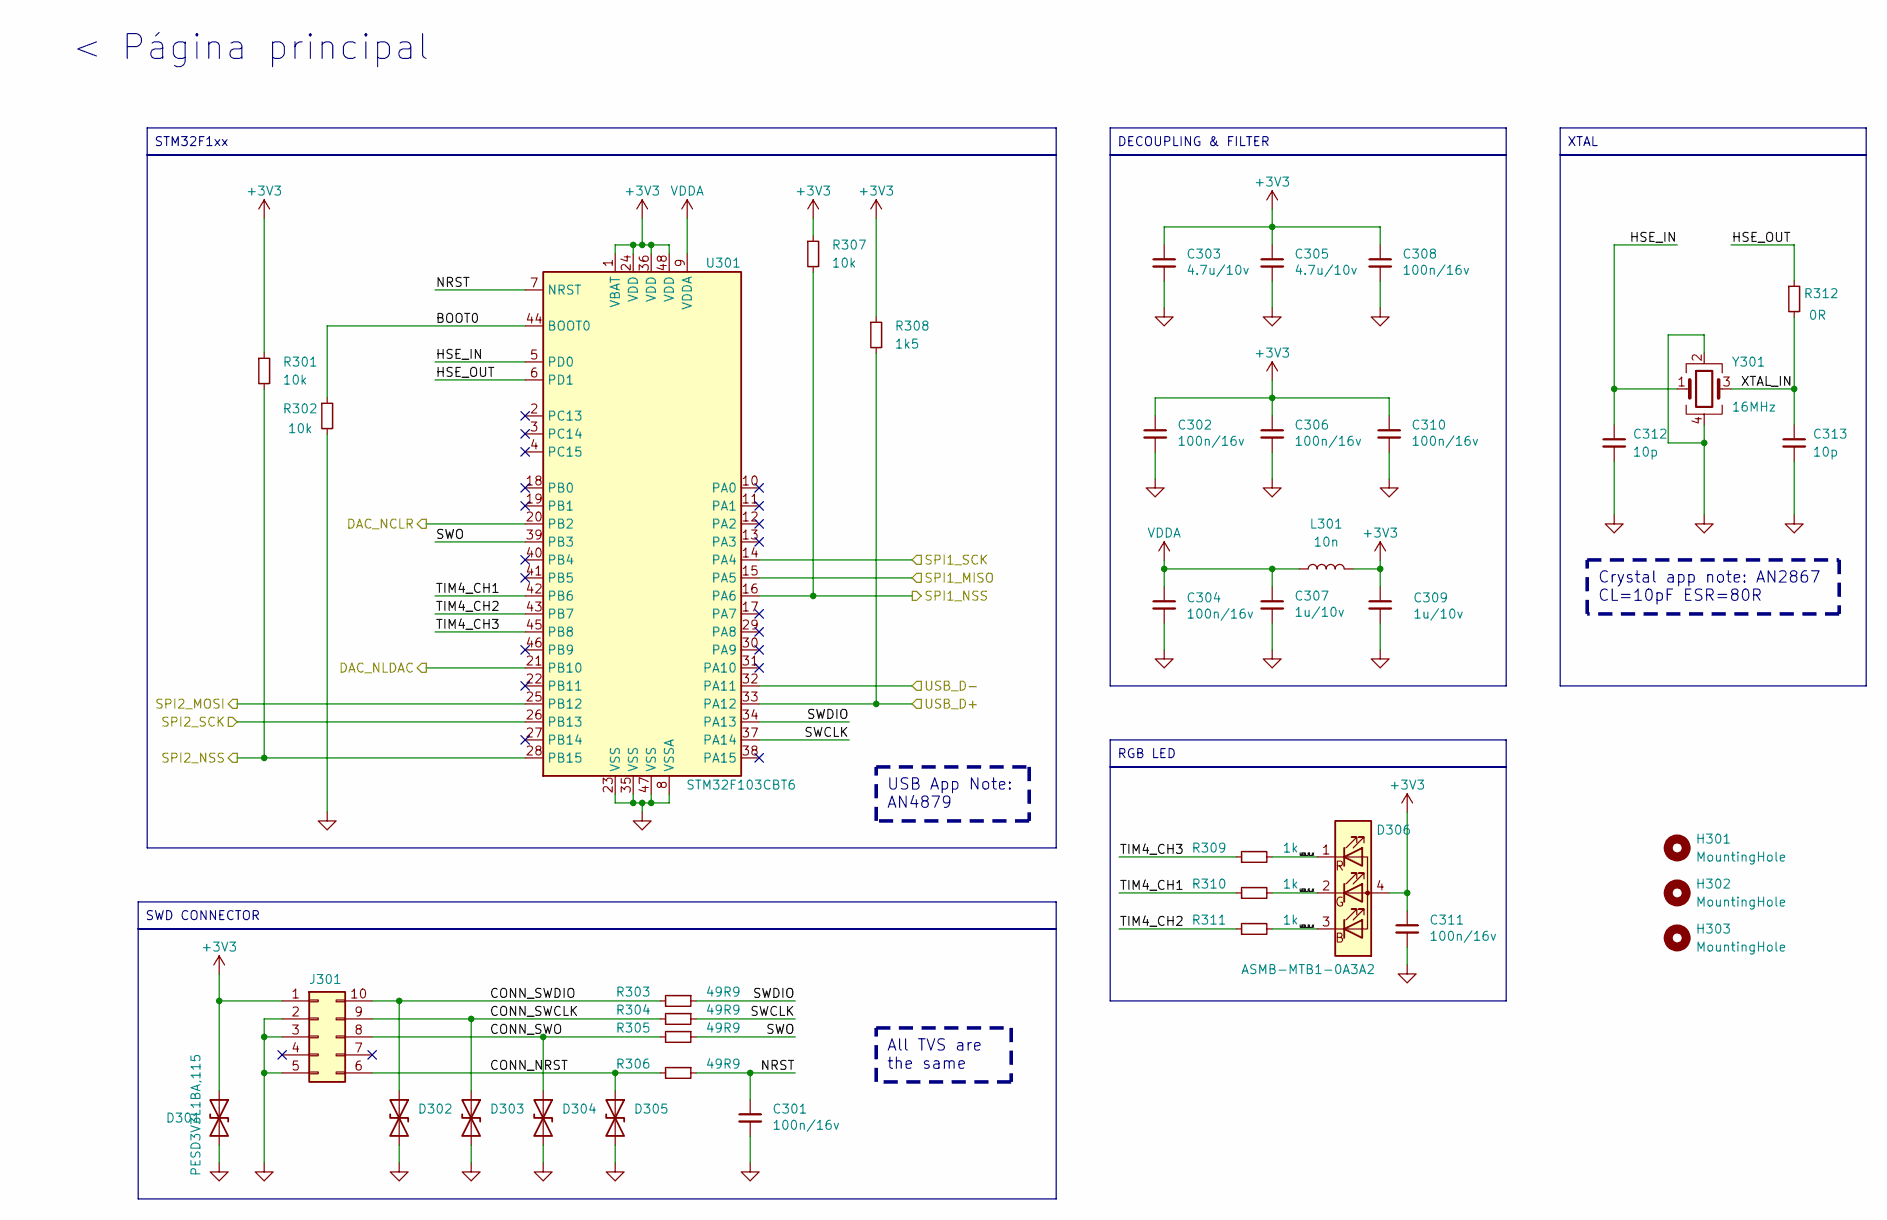
[picture p21: schematic micro.kicad_sch, Miced Signal demo board]

Parts:
C301, C302, C304, C306, C308, C310, C311: 100n/16v; C_0402_1005Metric_Pad0.74x0.62mm_HandSolder; PART_NUMBER GRM155R71C104KA88J
C303, C305: 4.7u/10v; C_0402_1005Metric_Pad0.74x0.62mm_HandSolder; PART_NUMBER C1005X5R1A475K050BC
C307, C309: 1u/10v; C_0402_1005Metric_Pad0.74x0.62mm_HandSolder; PART_NUMBER CL05B104KP5NNNC
C312, C313: 10p; C_0402_1005Metric
D301, D302, D303, D304, D305: PESD3V3L1BA,115; D_SOD-323
D306: ASMB-MTB1-0A3A2; LED_Avago_PLCC4_3.2x2.8mm_CW
H301, H302, H303: MountingHole; MountingHole_3.2mm_M3
J301: Conn_02x05_Counter_Clockwise; PinHeader_2x05_P1.27mm_Vertical_SMD
L301: 10n; L_0402_1005Metric
R301, R302, R307: 10k; R_0402_1005Metric
R303, R304, R305, R306: 49R9; R_0402_1005Metric
R308: 1k5; R_0402_1005Metric
R309, R310, R311: 1k; R_0402_1005Metric
R312: 0R; R_0402_1005Metric
U301: STM32F103CBT6; LQFP-48_7x7mm_P0.5mm; Manufacturer Part Number STM32F103CBT6
Y301: 16MHz; Crystal_SMD_3225-4Pin_3.2x2.5mm

Connections:
+3V3: C302.1, C303.1, C305.1, C306.1, C308.1, C309.1, C310.1, C311.1, D301.1 (A1), D306.4 (A), J301.1, L301.2, R301.1, R307.1, R308.1, U301.1 (VBAT), U301.24 (VDD), U301.36 (VDD), U301.48 (VDD); also elsewhere on the board
/ADC/SPI1_MISO: U301.15 (PA5); also elsewhere on the board
/ADC/SPI1_NSS: R307.2, U301.16 (PA6); also elsewhere on the board
/ADC/SPI1_SCK: U301.14 (PA4); also elsewhere on the board
/DAC/DAC_NCLR: U301.20 (PB2); also elsewhere on the board
/DAC/DAC_NLDAC: U301.21 (PB10); also elsewhere on the board
/DAC/SPI2_MOSI: U301.25 (PB12); also elsewhere on the board
/DAC/SPI2_NSS: R301.2, U301.28 (PB15); also elsewhere on the board
/DAC/SPI2_SCK: U301.26 (PB13); also elsewhere on the board
/MICRO/BOOT0: R302.1, U301.44 (BOOT0)
/MICRO/CONN_NRST: D305.1 (A1), J301.6, R306.2
/MICRO/CONN_SWCLK: D303.1 (A1), J301.9, R304.2
/MICRO/CONN_SWDIO: D302.1 (A1), J301.10, R303.2
/MICRO/CONN_SWO: D304.1 (A1), J301.8, R305.2
/MICRO/HSE_IN: C312.1, U301.5 (PD0), Y301.1
/MICRO/HSE_OUT: R312.1, U301.6 (PD1)
/MICRO/LED_B_K: D306.3 (BK), R311.2
/MICRO/LED_G_K: D306.2 (GK), R310.2
/MICRO/LED_R_K: D306.1 (RK), R309.2
/MICRO/NRST: C301.1, R306.1, U301.7 (NRST)
/MICRO/SWCLK: R304.1, U301.37 (PA14)
/MICRO/SWDIO: R303.1, U301.34 (PA13)
/MICRO/SWO: R305.1, U301.39 (PB3)
/MICRO/TIM4_CH1: R310.1, U301.42 (PB6)
/MICRO/TIM4_CH2: R311.1, U301.43 (PB7)
/MICRO/TIM4_CH3: R309.1, U301.45 (PB8)
/MICRO/USB_D+: R308.2, U301.33 (PA12); also elsewhere on the board
/MICRO/USB_D-: U301.32 (PA11); also elsewhere on the board
/MICRO/XTAL_IN: C313.1, R312.2, Y301.3
GND: C301.2, C302.2, C303.2, C304.2, C305.2, C306.2, C307.2, C308.2, C309.2, C310.2, C311.2, C312.2, C313.2, D301.2 (A2), D302.2 (A2), D303.2 (A2), D304.2 (A2), D305.2 (A2), J301.2, J301.3, J301.5, R302.2, U301.8 (VSSA), U301.23 (VSS), U301.35 (VSS), U301.47 (VSS), Y301.2, Y301.4; also elsewhere on the board
VDDA: C304.1, C307.1, L301.1, U301.9 (VDDA)

Notes on the sheet:
USB App Note: AN4879
< Página principal
Crystal app note: AN2867 CL=10pF ESR=80R
SWD CONNECTOR
DECOUPLING & FILTER
All TVS are the same
RGB LED
XTAL
STM32F1xx

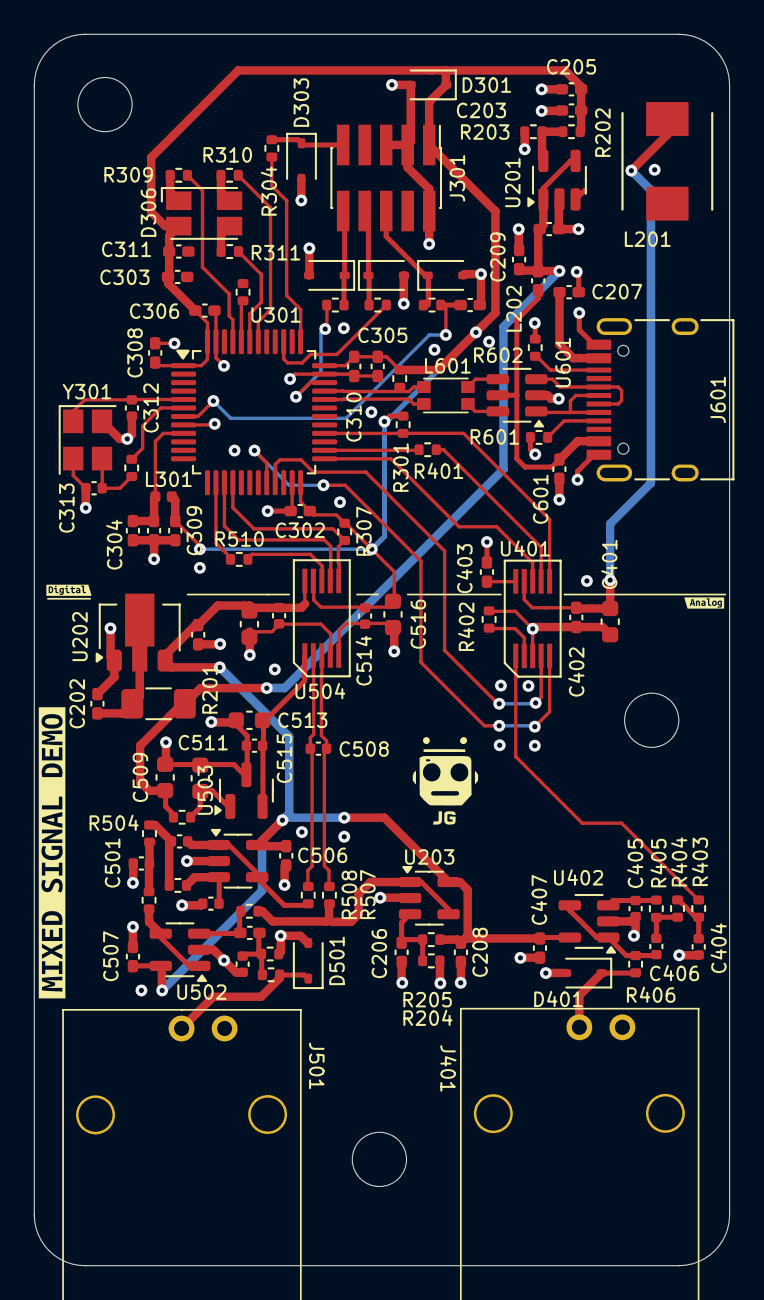
[picture p22: board mixed_signal.kicad_pcb from above]

Board: 4 copper layers, 41.0 x 72.7 mm, 115 parts (0 on the bottom side), 67 nets.

Other parts of the board:
kibuzzard-67B740F3: G***; kibuzzard-67B740F3
kibuzzard-67B741FF: G***; kibuzzard-67B741FF
kibuzzard-67B74215: G***; kibuzzard-67B74215
